Perhaps888/Perhaps888-MOCHAN_Robot/docs/images/camera-placeholder.jpg

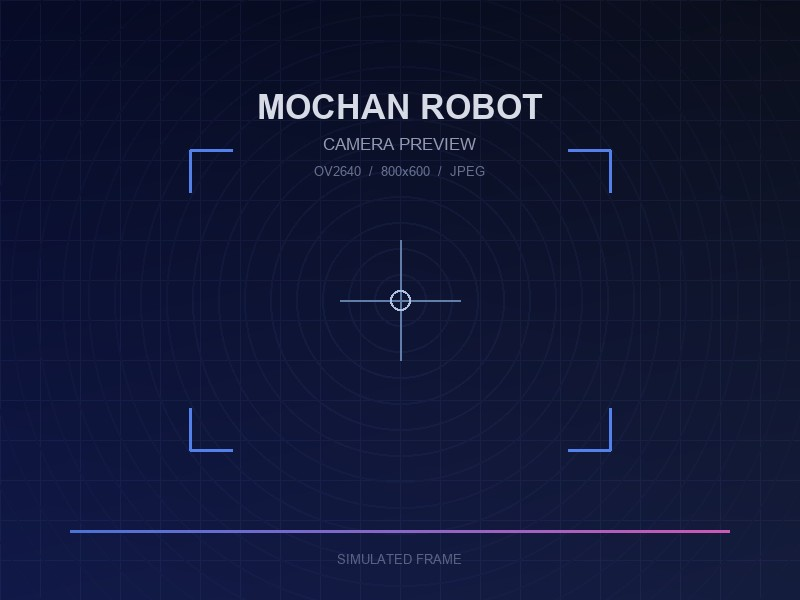
docs/images/camera-placeholder.jpg
