Perhaps888/Perhaps888-MOCHAN_Robot/web_content.h

#pragma once
/* ================================================================
 *  WEB UI 页面内容 (Samsung OneUI 8.5 风格)
 *  ---------------------------------------------------------------
 *  存为 PROGMEM (Flash 只读)，不占用宝贵的 DRAM。
 *  使用普通字符串字面量 + \" 转义，避免 Arduino IDE 的
 *  .ino 预处理器因不理解 R"delim()" 原始字符串语法而
 *  错误配对引号导致 JS function 关键字泄漏到 C++ 作用域。
 * ================================================================ */
#include <Arduino.h>  // PROGMEM 宏定义

/* 页面代码地图:
 *   1. CSS  : 主题变量、卡片、D-Pad、三档转速滑块、响应式布局
 *   2. HTML : 摄像头、方向控制、快捷操作、状态、网络设置
 *   3. JS   : WebSocket 控制、视频流、时钟、状态轮询、三档调速
 *
 * 说明:
 *   整个页面用 C++ 字符串拼接后放进 PROGMEM;
 *   下面新增的 // 注释只给源码阅读, 不会发送给浏览器.
 */
/* ====== 控制台主页面 (~508 行 HTML/CSS/JS) ====== */
const char PAGE_HTML_MAIN[] PROGMEM =
"<!DOCTYPE html>\n"
"<html lang=\"zh-CN\">\n"
"<head>\n"
"<meta charset=\"UTF-8\">\n"
"<meta name=\"viewport\" content=\"width=device-width, initial-scale=1.0, maximum-scale=1.0, user-scalable=no\">\n"
"<meta name=\"apple-mobile-web-app-capable\" content=\"yes\">\n"
"<meta name=\"theme-color\" content=\"#0B1020\">\n"
"<title>MOCHAN Robot · 控制台</title>\n"
"<style>\n"
"*,*::before,*::after{box-sizing:border-box;margin:0;padding:0;-webkit-tap-highlight-color:transparent}\n"
":root{\n"
"  --bg-1:#050816;--bg-2:#0B1030;--bg-3:#101A4A;\n"
"  --glass:rgba(255,255,255,.06);--glass-2:rgba(255,255,255,.10);\n"
"  --border:rgba(255,255,255,.12);\n"
"  --text:#E8ECF5;--text-2:#A8B0C5;--text-3:#76809A;\n"
"  --accent:#5B8CFF;--accent-2:#8A6BFF;--accent-g:linear-gradient(135deg,#5B8CFF,#8A6BFF 60%,#FF6BD6);\n"
"  --danger:#FF4D6A;--success:#3DDC97;--warn:#FFB547;\n"
"  --r-lg:26px;--r-md:18px;--r-sm:12px;--r-xs:10px;\n"
"  --sh-card:0 10px 40px rgba(0,0,0,.45), inset 0 1px 0 rgba(255,255,255,.06);\n"
"  /* ---- 设计 token (统一间距/过渡/焦点,便于桌面/平板差异化微调) ---- */\n"
"  --sp-1:6px;--sp-2:10px;--sp-3:14px;--sp-4:18px;--sp-5:24px;\n"
"  --tr-fast:.15s cubic-bezier(.4,0,.2,1);\n"
"  --tr-base:.25s cubic-bezier(.4,0,.2,1);\n"
"  --tr-slow:.4s cubic-bezier(.22,1,.36,1);\n"
"  --focus:0 0 0 3px rgba(91,140,255,.45);\n"
"}\n"
"html,body{height:100%}\n"
"body{\n"
"  font-family:-apple-system,BlinkMacSystemFont,\"Segoe UI\",\"PingFang SC\",\"Hiragino Sans GB\",\"Microsoft YaHei\",Roboto,sans-serif;\n"
"  color:var(--text);background:#050816;min-height:100vh;\n"
"  background-image:\n"
"    radial-gradient(1200px 600px at 10% -10%,rgba(91,140,255,.35),transparent 60%),\n"
"    radial-gradient(900px 500px at 110% 10%,rgba(138,107,255,.28),transparent 55%),\n"
"    radial-gradient(700px 500px at 50% 120%,rgba(255,107,214,.18),transparent 55%),\n"
"    linear-gradient(180deg,var(--bg-1),var(--bg-2) 50%,var(--bg-3));\n"
"  padding:18px 16px 120px;overflow-x:hidden;\n"
"}\n"
"body::before{content:\"\";position:fixed;inset:0;pointer-events:none;z-index:0;\n"
"  background-image:url(\"data:image/svg+xml;utf8,<svg xmlns='http://www.w3.org/2000/svg' width='120' height='120'><filter id='n'><feTurbulence baseFrequency='.85' numOctaves='2' seed='3'/><feColorMatrix values='0 0 0 0 1 0 0 0 0 1 0 0 0 0 1 0 0 0 .04 0'/></filter><rect width='100%25' height='100%25' filter='url(%23n)'/></svg>\");\n"
"  opacity:.6;mix-blend-mode:overlay;\n"
"}\n"
".container{max-width:760px;margin:0 auto;position:relative;z-index:1}\n"
"\n"
"/* ===== Header ===== */\n"
".header{\n"
"  display:flex;align-items:flex-end;justify-content:space-between;\n"
"  padding:6px 6px 18px;\n"
"}\n"
".h-left .greeting{font-size:13px;color:var(--text-3);letter-spacing:.5px}\n"
".h-left .clock{font-size:34px;font-weight:700;letter-spacing:1px;margin-top:2px;\n"
"  background:var(--accent-g);-webkit-background-clip:text;background-clip:text;color:transparent;\n"
"  text-shadow:0 0 24px rgba(91,140,255,.2);\n"
"}\n"
".h-left .date{font-size:13px;color:var(--text-2);margin-top:2px}\n"
".h-right{text-align:right}\n"
".brand{font-size:14px;font-weight:700;letter-spacing:1.5px;color:var(--text);opacity:.95}\n"
".brand-sub{font-size:11px;color:var(--text-3);margin-top:3px;letter-spacing:1px}\n"
".status-pill{\n"
"  display:inline-flex;align-items:center;gap:6px;margin-top:8px;\n"
"  padding:5px 10px;border-radius:999px;background:var(--glass);\n"
"  border:1px solid var(--border);font-size:11px;color:var(--text-2);backdrop-filter:blur(10px);\n"
"}\n"
".status-dot{width:7px;height:7px;border-radius:50%;background:var(--success);box-shadow:0 0 0 0 rgba(61,220,151,.7);animation:pulse 2s infinite}\n"
"@keyframes pulse{0%{box-shadow:0 0 0 0 rgba(61,220,151,.55)}70%{box-shadow:0 0 0 10px rgba(61,220,151,0)}100%{box-shadow:0 0 0 0 rgba(61,220,151,0)}}\n"
"\n"
"/* ===== Cards ===== */\n"
".card{\n"
"  margin-top:14px;border-radius:var(--r-lg);\n"
"  background:var(--glass);border:1px solid var(--border);\n"
"  backdrop-filter:blur(18px) saturate(140%);-webkit-backdrop-filter:blur(18px) saturate(140%);\n"
"  box-shadow:var(--sh-card);padding:18px 18px 20px;overflow:hidden;position:relative;\n"
"}\n"
".card::before{content:\"\";position:absolute;inset:-1px;border-radius:inherit;\n"
"  background:linear-gradient(135deg,rgba(255,255,255,.18),transparent 40%,transparent 60%,rgba(138,107,255,.18));\n"
"  -webkit-mask:linear-gradient(#000 0 0) content-box,linear-gradient(#000 0 0);\n"
"  -webkit-mask-composite:xor;mask-composite:exclude;padding:1px;pointer-events:none;z-index:0;\n"
"}\n"
".card>*{position:relative;z-index:1}\n"
".card-title{\n"
"  display:flex;align-items:center;gap:8px;font-size:15px;font-weight:700;margin-bottom:14px;\n"
"  letter-spacing:.3px;color:var(--text);\n"
"}\n"
".card-title::before{content:\"\";width:4px;height:16px;border-radius:4px;background:var(--accent-g)}\n"
".card-title .count{margin-left:auto;font-size:11px;color:var(--text-3);font-weight:500}\n"
"\n"
"/* ===== Camera Stream ===== */\n"
".stream-box{\n"
"  position:relative;border-radius:var(--r-md);overflow:hidden;\n"
"  background:#000;border:1px solid var(--border);\n"
"  box-shadow:inset 0 0 0 1px rgba(255,255,255,.04);\n"
"}\n"
".stream-header{\n"
"  position:absolute;top:10px;left:10px;right:10px;display:flex;justify-content:space-between;align-items:center;z-index:2;\n"
"}\n"
".stream-tag{padding:5px 10px;border-radius:999px;font-size:11px;font-weight:600;\n"
"  background:rgba(0,0,0,.5);backdrop-filter:blur(8px);border:1px solid var(--border);color:var(--text)}\n"
".live{padding:5px 10px;border-radius:999px;font-size:11px;font-weight:800;letter-spacing:1px;\n"
"  background:rgba(255,77,106,.18);color:#FF6B84;border:1px solid rgba(255,77,106,.4);\n"
"  display:inline-flex;align-items:center;gap:6px;backdrop-filter:blur(8px);\n"
"}\n"
".live::before{content:\"\";width:7px;height:7px;border-radius:50%;background:#FF4D6A;animation:blink 1.2s infinite}\n"
"@keyframes blink{0%,100%{opacity:1}50%{opacity:.25}}\n"
".stream-box img{width:100%;height:auto;display:block;\n"
"  transform:scale(1.001);transition:transform .4s ease;\n"
"}\n"
"/* AI 检测叠加层: 盖在视频上画框, 不拦截点击 */\n"
"#aiOverlay{position:absolute;left:0;top:0;width:100%;height:100%;pointer-events:none;z-index:3}\n"
".ai-btn{background:linear-gradient(135deg,#1c2b4a,#16213c);border:1px solid var(--border);color:#7fd0ff;\n"
"  border-radius:999px;padding:4px 12px;font-size:12px;cursor:pointer;transition:all .2s}\n"
".ai-btn.on{background:linear-gradient(135deg,#0b5ed7,#0a3d91);color:#fff;border-color:#0d6efd}\n"
".ai-btn:disabled{opacity:.45;cursor:default}\n"
".ai-state{color:var(--text-3);font-size:12px}\n"
"/* AI 模型上传弹窗 */\n"
"#aiModal{position:fixed;inset:0;background:rgba(0,0,0,.65);display:none;place-items:center;z-index:50}\n"
"#aiModal.show{display:grid}\n"
".ai-modal-card{background:#10162b;border:1px solid var(--border);border-radius:16px;padding:22px;width:min(92vw,420px)}\n"
".ai-modal-card h3{margin:0 0 6px;color:#fff;font-size:16px}\n"
".ai-modal-card p{margin:0 0 12px;color:var(--text-3);font-size:12px;line-height:1.7}\n"
".ai-modal-card code{color:#7fd0ff}\n"
"#aiFile{width:100%;color:#ccc;font-size:12px;margin-bottom:10px}\n"
"#aiUpProg{font-size:12px;color:#6f6;white-space:pre-line;min-height:1.2em}\n"
".stream-box:hover img{transform:scale(1.01)}\n"
".stream-foot{\n"
"  margin-top:10px;display:flex;justify-content:space-between;align-items:center;font-size:12px;color:var(--text-3);\n"
"}\n"
".stream-foot .res{padding:3px 8px;border-radius:8px;background:var(--glass);border:1px solid var(--border);color:var(--text-2);font-size:11px}\n"
"\n"
"/* ===== D-Pad ===== */\n"
".dpad{\n"
"  --s:260px;width:100%;max-width:var(--s);aspect-ratio:1;margin:8px auto 4px;\n"
"  display:grid;grid-template-columns:repeat(3,1fr);grid-template-rows:repeat(3,1fr);gap:10px;\n"
"  padding:8px;\n"
"}\n"
".dpad .btn{\n"
"  position:relative;appearance:none;border:none;cursor:pointer;\n"
"  border-radius:22px;background:var(--glass);border:1px solid var(--border);\n"
"  color:var(--text);font-size:22px;font-weight:700;\n"
"  display:flex;align-items:center;justify-content:center;\n"
"  box-shadow:inset 0 1px 0 rgba(255,255,255,.08),0 6px 20px rgba(0,0,0,.3);\n"
"  transition:transform .12s ease,background .2s,box-shadow .2s,color .2s;user-select:none;\n"
"}\n"
".dpad .btn:hover{background:var(--glass-2)}\n"
".dpad .btn:active{transform:scale(.92);box-shadow:inset 0 2px 8px rgba(0,0,0,.45)}\n"
".dpad .up{grid-column:2;grid-row:1}\n"
".dpad .left{grid-column:1;grid-row:2}\n"
".dpad .right{grid-column:3;grid-row:2}\n"
".dpad .down{grid-column:2;grid-row:3}\n"
".dpad .stop{\n"
"  grid-column:2;grid-row:2;border-radius:50%;\n"
"  background:var(--accent-g);color:#fff;font-size:14px;letter-spacing:1px;\n"
"  box-shadow:0 8px 30px rgba(91,140,255,.35),inset 0 1px 0 rgba(255,255,255,.25);\n"
"}\n"
".dpad .stop:active{box-shadow:0 4px 14px rgba(91,140,255,.35)}\n"
".dpad .btn span{opacity:.85}\n"
".hint{text-align:center;font-size:11px;color:var(--text-3);margin-top:4px}\n"
"\n"
"/* ===== 电机转速滑块 (DRV8833 · 3 档) ===== */\n"
".speed-box{margin-top:16px;padding-top:14px;border-top:1px solid rgba(255,255,255,.08)}\n"
".sp-head{display:flex;align-items:center;gap:8px;margin-bottom:6px}\n"
".sp-ico{width:28px;height:28px;flex:0 0 auto;display:grid;place-items:center;border-radius:9px;\n"
"  background:rgba(91,140,255,.14);border:1px solid rgba(91,140,255,.25);font-size:14px}\n"
".sp-title{font-size:12.5px;font-weight:700;color:var(--text-2);letter-spacing:.3px}\n"
".sp-badge{margin-left:auto;display:inline-flex;align-items:baseline;gap:5px;padding:4px 10px;border-radius:999px;\n"
"  background:var(--glass);border:1px solid var(--border);font-size:10.5px;color:var(--text-3);font-variant-numeric:tabular-nums}\n"
".sp-badge b{font-size:12.5px;font-weight:800;color:var(--text);letter-spacing:.5px}\n"
".sp-shell{padding:2px 11px 0}\n"
".sp-range{--fill:100%;-webkit-appearance:none;appearance:none;display:block;width:100%;height:30px;margin:0;\n"
"  background:transparent;outline:none;cursor:pointer;touch-action:pan-y}\n"
".sp-range::-webkit-slider-runnable-track{height:8px;border-radius:999px;border:1px solid var(--border);\n"
"  background-color:rgba(91,140,255,.12);\n"
"  background-image:linear-gradient(90deg,#5B8CFF,#8A6BFF 55%,#FF6BD6);\n"
"  background-size:var(--fill) 100%;background-repeat:no-repeat;\n"
"  box-shadow:inset 0 1px 2px rgba(0,0,0,.35)}\n"
".sp-range::-webkit-slider-thumb{-webkit-appearance:none;appearance:none;width:22px;height:22px;margin-top:-8px;\n"
"  border-radius:50%;border:2px solid rgba(160,190,255,.95);background:linear-gradient(180deg,#fff,#D9E2FF);\n"
"  box-shadow:0 3px 12px rgba(91,140,255,.55),0 0 0 4px rgba(91,140,255,.10);\n"
"  transition:transform var(--tr-fast),box-shadow var(--tr-fast)}\n"
".sp-range:active::-webkit-slider-thumb{transform:scale(1.08);\n"
"  box-shadow:0 4px 18px rgba(91,140,255,.7),0 0 0 6px rgba(91,140,255,.14)}\n"
".sp-range:focus-visible{outline:none}\n"
".sp-range::-moz-range-track{height:8px;border-radius:999px;border:1px solid var(--border);background:rgba(91,140,255,.12)}\n"
".sp-range::-moz-range-progress{height:8px;border-radius:999px;background:linear-gradient(90deg,#5B8CFF,#8A6BFF 55%,#FF6BD6)}\n"
".sp-range::-moz-range-thumb{width:20px;height:20px;border-radius:50%;border:2px solid rgba(160,190,255,.95);\n"
"  background:linear-gradient(180deg,#fff,#D9E2FF);box-shadow:0 3px 12px rgba(91,140,255,.55)}\n"
".sp-scale{display:flex;justify-content:space-between;margin-top:2px}\n"
".sp-step{appearance:none;border:none;background:transparent;color:var(--text-3);cursor:pointer;\n"
"  display:flex;flex-direction:column;align-items:center;gap:4px;padding:2px 0 1px;min-width:30px;\n"
"  font-family:inherit;font-size:11px;font-weight:600;letter-spacing:.5px;transition:color var(--tr-fast)}\n"
".sp-step i{display:block;width:5px;height:5px;border-radius:50%;background:rgba(255,255,255,.18);transition:all var(--tr-fast)}\n"
".sp-step:hover{color:var(--text-2)}\n"
".sp-step.active{color:var(--text)}\n"
".sp-step.active i{background:var(--accent);box-shadow:0 0 8px rgba(91,140,255,.95);transform:scale(1.15)}\n"
".sp-sub{display:flex;justify-content:space-between;gap:10px;margin-top:6px;font-size:10.5px;color:var(--text-3);letter-spacing:.2px}\n"
".sp-sub b{color:var(--text-2);font-weight:600}\n"
"\n"
"/* ===== Segmented (运行模式) ===== */\n"
".seg{\n"
"  display:grid;grid-template-columns:repeat(3,1fr);gap:8px;padding:6px;\n"
"  border-radius:999px;background:var(--glass);border:1px solid var(--border);\n"
"}\n"
".seg button{\n"
"  appearance:none;border:none;cursor:pointer;padding:10px 8px;border-radius:999px;\n"
"  background:transparent;color:var(--text-2);font-size:13px;font-weight:600;letter-spacing:.3px;\n"
"  transition:all .25s ease;\n"
"}\n"
".seg button.active,.seg button.on{\n"
"  background:var(--accent-g);color:#fff;box-shadow:0 6px 20px rgba(91,140,255,.3);\n"
"}\n"
".seg button:not(.active):not(.on):hover{background:rgba(255,255,255,.05);color:var(--text)}\n"
"\n"
"/* ===== Buttons ===== */\n"
".btn-primary,.btn-ghost{\n"
"  appearance:none;border:none;cursor:pointer;width:100%;padding:12px 14px;\n"
"  border-radius:var(--r-sm);font-size:13.5px;font-weight:700;letter-spacing:.3px;\n"
"  display:inline-flex;align-items:center;justify-content:center;gap:8px;transition:all .2s ease;\n"
"}\n"
".btn-primary{\n"
"  background:var(--accent-g);color:#fff;\n"
"  box-shadow:0 10px 26px rgba(91,140,255,.3),inset 0 1px 0 rgba(255,255,255,.2);\n"
"}\n"
".btn-primary:hover{transform:translateY(-1px);box-shadow:0 14px 34px rgba(91,140,255,.4),inset 0 1px 0 rgba(255,255,255,.25)}\n"
".btn-primary:active{transform:translateY(0);box-shadow:0 6px 16px rgba(91,140,255,.35)}\n"
".btn-ghost{background:var(--glass);color:var(--text);border:1px solid var(--border)}\n"
".btn-ghost:hover{background:var(--glass-2)}\n"
".btn-primary.loading{pointer-events:none;opacity:.8}\n"
".btn-primary .spin{width:14px;height:14px;border:2px solid rgba(255,255,255,.3);border-top-color:#fff;border-radius:50%;animation:spin .8s linear infinite}\n"
"@keyframes spin{to{transform:rotate(360deg)}}\n"
"\n"
"/* ===== 屏幕文字发送条 ===== */\n"
".chatbar{\n"
"  margin-top:18px;padding:7px 7px 7px 16px;border-radius:999px;\n"
"  display:flex;align-items:center;gap:10px;\n"
"  background:rgba(8,12,30,.55);border:1px solid var(--border);\n"
"  backdrop-filter:blur(10px);\n"
"  box-shadow:inset 0 1px 0 rgba(255,255,255,.05),0 8px 22px rgba(0,0,0,.28);\n"
"  transition:border-color .25s,box-shadow .25s,background .25s;\n"
"}\n"
".chatbar:focus-within{\n"
"  border-color:transparent;background:rgba(10,15,38,.82);\n"
"  box-shadow:0 0 0 2px rgba(91,140,255,.5),0 10px 28px rgba(91,140,255,.22),inset 0 1px 0 rgba(255,255,255,.06);\n"
"}\n"
".chatbar .cb-ico{font-size:15px;line-height:1;opacity:.75;flex:0 0 auto;filter:saturate(1.1)}\n"
".chatbar input{\n"
"  flex:1;min-width:0;appearance:none;border:none;background:transparent;outline:none;\n"
"  color:var(--text);font-size:13.5px;font-weight:500;letter-spacing:.2px;padding:9px 2px;\n"
"}\n"
".chatbar input::placeholder{color:var(--text-3);font-weight:400}\n"
".chatbar .cb-count{font-size:10px;color:var(--text-3);font-variant-numeric:tabular-nums;flex:0 0 auto;padding-right:2px}\n"
".chatbar .cb-send{\n"
"  appearance:none;border:none;cursor:pointer;flex:0 0 auto;\n"
"  height:38px;padding:0 18px;border-radius:999px;\n"
"  background:var(--accent-g);color:#fff;font-size:13px;font-weight:700;letter-spacing:.5px;\n"
"  display:inline-flex;align-items:center;gap:6px;\n"
"  box-shadow:0 8px 20px rgba(91,140,255,.34),inset 0 1px 0 rgba(255,255,255,.22);\n"
"  transition:transform .18s,box-shadow .18s,filter .18s;\n"
"}\n"
".chatbar .cb-send:hover{transform:translateY(-1px);box-shadow:0 12px 26px rgba(91,140,255,.44),inset 0 1px 0 rgba(255,255,255,.25)}\n"
".chatbar .cb-send:active{transform:translateY(0) scale(.97);box-shadow:0 5px 14px rgba(91,140,255,.32)}\n"
"@media(max-width:600px){\n"
"  .chatbar{padding:6px 6px 6px 14px}\n"
"  .chatbar .cb-send{height:36px;padding:0 15px}\n"
"}\n"
"\n"
"/* ===== 设备状态仪表盘 ===== */\n"
".tele-grid{display:grid;grid-template-columns:1fr 1fr;gap:10px}\n"
".tele{display:flex;align-items:center;gap:11px;padding:12px 14px;border-radius:16px;background:var(--glass);border:1px solid var(--border)}\n"
".t-ico{font-size:17px;flex:0 0 auto;width:34px;height:34px;display:grid;place-items:center;border-radius:11px;background:rgba(91,140,255,.14);border:1px solid rgba(91,140,255,.25)}\n"
".t-body{min-width:0}\n"
".t-val{font-size:13.5px;font-weight:700;color:var(--text);font-variant-numeric:tabular-nums;line-height:1.25;white-space:nowrap}\n"
".t-k{font-size:10.5px;color:var(--text-3);margin-top:2px;white-space:nowrap;overflow:hidden;text-overflow:ellipsis}\n"
"\n"
"/* ===== 小车状态 + 表情 ===== */\n"
".car-dir{display:flex;align-items:center;gap:13px;padding:13px 15px;border-radius:16px;background:var(--glass);border:1px solid var(--border)}\n"
".cd-ico{font-size:20px;width:46px;height:46px;flex:0 0 auto;display:grid;place-items:center;border-radius:14px;background:linear-gradient(135deg,rgba(91,140,255,.22),rgba(138,107,255,.22));border:1px solid var(--border)}\n"
".cd-meta{flex:1;min-width:0}\n"
".cd-txt{font-size:14.5px;font-weight:700;line-height:1.2}\n"
".cd-sub{font-size:11px;color:var(--text-3);margin-top:3px;white-space:nowrap;overflow:hidden;text-overflow:ellipsis}\n"
".cd-dot{width:9px;height:9px;border-radius:50%;background:var(--text-3);flex:0 0 auto;transition:background .3s}\n"
".cd-dot.run{background:#3DDC97;box-shadow:0 0 10px rgba(61,220,151,.9);animation:pulseDot 1.2s ease-in-out infinite}\n"
"@keyframes pulseDot{0%,100%{opacity:1}50%{opacity:.35}}\n"
".mood-label{font-size:11px;color:var(--text-3);margin:14px 2px 8px;letter-spacing:.5px}\n"
".moods{display:grid;grid-template-columns:repeat(4,1fr);gap:8px}\n"
".mood{appearance:none;border:1px solid var(--border);background:var(--glass);color:var(--text-2);border-radius:14px;padding:10px 4px 8px;cursor:pointer;font-size:18px;line-height:1;display:flex;flex-direction:column;align-items:center;gap:5px;transition:all .2s}\n"
".mood span{font-size:11px;font-weight:600}\n"
".mood:hover{background:var(--glass-2);transform:translateY(-1px)}\n"
".mood.active{border-color:transparent;background:rgba(91,140,255,.16);color:var(--text);box-shadow:0 0 0 1.5px rgba(91,140,255,.55),0 10px 24px rgba(91,140,255,.25)}\n"
"\n"
"/* ===== Quick Actions ===== */\n"
".quick{display:grid;grid-template-columns:repeat(3,1fr);gap:10px}\n"
"\n"
"/* ===== WiFi 设置 ===== */\n"
".wifi-card .wifi-status{display:flex;align-items:center;gap:11px;padding:13px 15px;border-radius:16px;background:var(--glass);border:1px solid var(--border);margin-bottom:12px}\n"
".wifi-card .ws-ico{font-size:20px;width:42px;height:42px;flex:0 0 auto;display:grid;place-items:center;border-radius:13px;background:linear-gradient(135deg,rgba(91,140,255,.22),rgba(138,107,255,.22));border:1px solid var(--border)}\n"
".wifi-card .ws-info{flex:1;min-width:0}\n"
".wifi-card .ws-ssid{font-size:14px;font-weight:700;line-height:1.2;white-space:nowrap;overflow:hidden;text-overflow:ellipsis}\n"
".wifi-card .ws-ip{font-size:11px;color:var(--text-3);margin-top:2px;font-variant-numeric:tabular-nums}\n"
".wifi-card .ws-badge{font-size:10px;font-weight:700;padding:3px 9px;border-radius:999px;flex:0 0 auto;letter-spacing:.5px}\n"
".wifi-card .ws-badge.sta{background:rgba(61,220,151,.16);color:#3DDC97;border:1px solid rgba(61,220,151,.3)}\n"
".wifi-card .ws-badge.ap{background:rgba(255,170,46,.14);color:#FFAA2E;border:1px solid rgba(255,170,46,.28)}\n"
".wifi-card .wifi-input{appearance:none;width:100%;border:1px solid var(--border);background:var(--glass);color:var(--text);font-size:13.5px;font-weight:500;padding:11px 14px;border-radius:14px;outline:none;transition:border-color .2s,box-shadow .2s;box-sizing:border-box}\n"
".wifi-card .wifi-input:focus{border-color:rgba(91,140,255,.5);box-shadow:0 0 0 3px rgba(91,140,255,.15)}\n"
".wifi-card .wifi-input::placeholder{color:var(--text-3);font-weight:400}\n"
".wifi-scan-wrap{display:flex;gap:8px;align-items:center;margin-bottom:10px}\n"
".wifi-scan-wrap .wifi-input{flex:1}\n"
".wifi-scan-btn{appearance:none;border:1px solid var(--border);background:var(--glass);color:var(--text);font-size:13px;font-weight:600;padding:11px 16px;border-radius:14px;cursor:pointer;flex:0 0 auto;transition:all .2s;display:flex;align-items:center;gap:5px}\n"
".wifi-scan-btn:hover{background:var(--glass-2);transform:translateY(-1px)}\n"
".wifi-scan-btn:active{transform:translateY(0)}\n"
".wifi-scan-btn:disabled{opacity:.5;cursor:default}\n"
".wifi-list{width:100%;border:1px solid var(--border);background:var(--glass);color:var(--text);border-radius:14px;padding:6px;margin-bottom:10px;outline:none;font-size:13px;max-height:140px}\n"
".wifi-list option{padding:8px 10px;border-radius:8px}\n"
".wifi-list option:checked{background:rgba(91,140,255,.2)}\n"
".wifi-actions{display:grid;grid-template-columns:1fr 1fr;gap:10px}\n"
".wifi-btn{appearance:none;border:none;cursor:pointer;padding:12px;border-radius:14px;font-size:13px;font-weight:700;letter-spacing:.3px;transition:all .2s;display:flex;align-items:center;justify-content:center;gap:6px}\n"
".wifi-btn:active{transform:scale(.97)}\n"
".wifi-btn.connect{background:linear-gradient(135deg,#5B8CFF,#6B5BFF);color:#fff;box-shadow:0 8px 20px rgba(91,140,255,.34)}\n"
".wifi-btn.connect:hover{box-shadow:0 12px 28px rgba(91,140,255,.44);transform:translateY(-1px)}\n"
".wifi-btn.apmode{background:var(--glass);border:1px solid var(--border);color:var(--text-2)}\n"
".wifi-btn.apmode:hover{background:var(--glass-2);transform:translateY(-1px)}\n"
".wifi-hint{font-size:11px;color:var(--text-3);line-height:1.55;margin-top:10px;display:flex;gap:6px;align-items:flex-start}\n"
".wifi-hint::before{content:\"ⓘ\";flex:0 0 auto;font-size:13px;opacity:.7}\n"
".qa{\n"
"  appearance:none;border:none;cursor:pointer;padding:16px 6px 14px;border-radius:20px;\n"
"  background:var(--glass);border:1px solid var(--border);color:var(--text);text-align:center;\n"
"  transition:all .25s ease;display:flex;flex-direction:column;align-items:center;gap:4px;position:relative;overflow:hidden;\n"
"}\n"
".qa::after{content:\"\";position:absolute;inset:0;background:var(--accent-g);opacity:0;transition:opacity .3s;mix-blend-mode:overlay;pointer-events:none}\n"
".qa:hover{transform:translateY(-2px);background:var(--glass-2);box-shadow:0 14px 30px rgba(0,0,0,.4)}\n"
".qa:hover::after{opacity:.4}\n"
".qa:active{transform:translateY(0)}\n"
"/* 运行模式激活态:蓝色描边+柔光投影+渐变叠加混色层更明显 */\n"
".qa.active{\n"
"  border-color:transparent;\n"
"  background:rgba(91,140,255,.16);\n"
"  box-shadow:0 0 0 1.5px rgba(91,140,255,.55),0 14px 34px rgba(91,140,255,.28)\n"
"}\n"
".qa.active::after{opacity:.55}\n"
".qa .ico{font-size:26px;line-height:1}\n"
".qa .lbl{font-size:13px;font-weight:700}\n"
".qa .dsc{font-size:10.5px;color:var(--text-3)}\n"
"\n"
"/* ===== Footer ===== */\n"
".footer{\n"
"  margin-top:24px;text-align:center;font-size:11px;color:var(--text-3);letter-spacing:1.2px;\n"
"  opacity:.8;\n"
"}\n"
".footer .bar{margin:0 auto 8px;width:38px;height:4px;border-radius:999px;\n"
"  background:linear-gradient(90deg,var(--accent),var(--accent-2));opacity:.7}\n"
"\n"
"/* ===== Toast ===== */\n"
".toast{\n"
"  position:fixed;left:50%;top:20px;transform:translate(-50%,-20px);z-index:999;\n"
"  padding:10px 16px;border-radius:999px;font-size:12.5px;font-weight:600;\n"
"  background:rgba(15,20,48,.9);color:#fff;border:1px solid var(--border);\n"
"  backdrop-filter:blur(14px);box-shadow:0 10px 40px rgba(0,0,0,.5);\n"
"  opacity:0;pointer-events:none;transition:opacity .25s,transform .25s;\n"
"}\n"
".toast.show{opacity:1;transform:translate(-50%,0)}\n"
".toast.ok{border-color:rgba(61,220,151,.35)}\n"
".toast.err{border-color:rgba(255,77,106,.45)}\n"
"\n"
"/* ===== 全局桌面体验增强 ===== */\n"
"@media (hover:hover) and (pointer:fine){\n"
"  html{scroll-behavior:smooth}\n"
"  button:focus-visible,a:focus-visible,input:focus-visible,select:focus-visible{\n"
"    outline:none;box-shadow:var(--focus),0 6px 24px rgba(91,140,255,.18);border-radius:inherit\n"
"  }\n"
"  ::selection{background:rgba(91,140,255,.35);color:#fff}\n"
"}\n"
"\n"
"/* ===== 平板 (768-1023px): 轻微放宽, 保持单栏 ===== */\n"
"@media (min-width:768px) and (max-width:1023px){\n"
"  .container{max-width:740px}\n"
"  body{padding:26px 20px 120px}\n"
"  .h-left .clock{font-size:40px;letter-spacing:1.5px}\n"
"  .dpad{--s:290px;gap:12px}\n"
"  .card{padding:20px 20px 22px}\n"
"  .card-title{margin-bottom:16px}\n"
"  .quick .qa{padding:18px 10px 16px}\n"
"  .quick .qa .ico{font-size:28px}\n"
"  .seg button{padding:11px 10px;font-size:13.5px}\n"
"}\n"
"\n"
"/* ===== 桌面端 (>=1024px): 双栏网格, 左(画面/状态)右(控制/快捷) ===== */\n"
"@media (min-width:1024px){\n"
"  body{padding:32px 28px 140px}\n"
"  .container{\n"
"    max-width:1180px;\n"
"    display:grid;\n"
"    grid-template-columns:1.25fr 1fr;\n"
"    grid-template-rows:auto auto auto auto auto;\n"
"    grid-template-areas:\n"
"      \"header header\"\n"
"      \"cam    dpad\"\n"
"      \"stats  quick\"\n"
"      \"car    quick\"\n"
"      \"footer footer\";\n"
"    column-gap:24px;row-gap:18px;align-items:stretch\n"
"  }\n"
"  /* 顶部区域全宽 */\n"
"  .container>.header{grid-area:header;padding:8px 8px 10px;align-items:center}\n"
"  .header .h-left .greeting{font-size:13px}\n"
"  .header .h-left .clock{font-size:48px;letter-spacing:2px}\n"
"  .header .h-left .date{font-size:13.5px;margin-top:4px}\n"
"  .header .h-right .brand{font-size:15px;letter-spacing:2px}\n"
"  .header .h-right .brand-sub{font-size:12px}\n"
"  .header .status-pill{padding:7px 14px;font-size:12px;gap:8px}\n"
"  /* 卡片在 grid 中取消外边距,统一由 row-gap 控制,内 padding 加大更宽松 */\n"
".container>.card{margin-top:0;padding:22px 24px 24px;border-radius:28px}\n"
".container>.card .card-title{font-size:16px;margin-bottom:16px;letter-spacing:.4px}\n"
"  /* 左栏:摄像头(跨2行,对齐右栏 D-Pad+快捷操作 的总高度) */\n"
".container>.card-cam{grid-area:cam}\n"
".stream-box{border-radius:22px}\n"
".stream-foot{margin-top:14px;font-size:13px}\n"
"  /* 右栏顶部:方向控制 */\n"
".container>.card-dpad{grid-area:dpad}\n"
".dpad{--s:320px;gap:14px;padding:10px}\n"
".dpad .btn{font-size:24px;border-radius:24px}\n"
".dpad .stop{font-size:15px}\n"
".container>.card-stats{grid-area:stats}\n"
".container>.card-car{grid-area:car}\n"
"  /* 右栏底部:快捷操作(含运行模式 3列×2行; 跨2行与状态两卡对齐) */\n"
".container>.card-quick{grid-area:quick}\n"
".quick{gap:12px}\n"
".quick .qa{padding:18px 8px 16px;border-radius:22px}\n"
".quick .qa .ico{font-size:28px}\n"
".quick .qa .lbl{font-size:13px}\n"
".quick .qa .dsc{font-size:10.5px}\n"
"  /* 底部全宽 */\n"
"  .container>.footer{grid-area:footer;margin-top:14px;font-size:12px}\n"
"}\n"
"\n"
"/* ===== 大桌面 (>=1440px): 进一步加宽与留白 ===== */\n"
"@media (min-width:1440px){\n"
"  .container{max-width:1320px;column-gap:28px;row-gap:20px}\n"
"  body{padding:38px 40px 160px}\n"
"  .container>.card{padding:26px 28px 28px;border-radius:30px}\n"
"  .header .h-left .clock{font-size:52px}\n"
"  .dpad{--s:340px}\n"
"}\n"
"</style>\n"
"</head>\n"
"<body>\n"
"<div class=\"container\">\n"
"\n"
"  <div class=\"header\">\n"
"    <div class=\"h-left\">\n"
"      <div class=\"greeting\">HELLO, 欢迎回来</div>\n"
"      <div class=\"clock\" id=\"clock\">--:--</div>\n"
"      <div class=\"date\" id=\"date\">--月--日 周-</div>\n"
"    </div>\n"
"    <div class=\"h-right\">\n"
"      <div class=\"brand\">MOCHAN</div>\n"
"      <div class=\"brand-sub\">OneUI 8.5 · Console</div>\n"
"      <div class=\"status-pill\"><span class=\"status-dot\"></span><span id=\"netState\">联机</span></div>\n"
"    </div>\n"
"  </div>\n"
"\n"
"  <!-- 摄像头 -->\n"
"  <div class=\"card card-cam\">\n"
"    <div class=\"card-title\">摄像头预览<span class=\"count\">WS · 实时</span></div>\n"
"    <div class=\"stream-box\">\n"
"      <div class=\"stream-header\">\n"
"        <span class=\"stream-tag\">CAM · 主视角</span>\n"
"        <span class=\"live\">LIVE</span>\n"
"      </div>\n"
"      <img id=\"camStream\" alt=\"Camera Stream\">\n"
"      <canvas id=\"aiOverlay\"></canvas>\n"
"    </div>\n"
"    <div class=\"stream-foot\">\n"
"      <span>分辨率：<span class=\"res\" id=\"resTag\">--</span></span>\n"
"      <span id=\"fpsTag\">FPS · 自适应</span>\n"
"      <span class=\"ai-state\" id=\"aiState\"></span>\n"
"      <button class=\"ai-btn\" id=\"aiBtn\" type=\"button\">🧠 AI 检测</button>\n"
"      <button class=\"ai-btn\" id=\"followBtn\" type=\"button\">🚶 跟随</button>\n"
"    </div>\n"
"  </div>\n"
"\n"
"  <!-- AI 模型上传弹窗 (仅在模型未上传时出现) -->\n"
"  <div id=\"aiModal\">\n"
"    <div class=\"ai-modal-card\">\n"
"      <h3>🧠 上传 AI 模型文件</h3>\n"
"      <p>首次使用需上传 3 个文件（在固件源码目录的 <code>ai_assets</code> 文件夹里），\n"
"      存进机器人 Flash，之后永久离线可用：<br>\n"
"      <code>ort.wasm.min.js.gz</code><br>\n"
"      <code>ort-wasm-simd.wasm.gz</code><br>\n"
"      <code>yolov8n.onnx.gz</code></p>\n"
"      <input type=\"file\" id=\"aiFile\" accept=\".gz\" multiple>\n"
"      <div id=\"aiUpProg\"></div>\n"
"    </div>\n"
"  </div>\n"
"\n"
"  <!-- 方向控制 -->\n"
"  <div class=\"card card-dpad\">\n"
"    <div class=\"card-title\">方向控制<span class=\"count\">按下即发送</span></div>\n"
"    <div class=\"dpad\" id=\"dpad\">\n"
"      <button class=\"btn up\" data-cmd=\"f\" aria-label=\"前进\"><span>▲</span></button>\n"
"      <button class=\"btn left\" data-cmd=\"l\" aria-label=\"左转\"><span>◀</span></button>\n"
"      <button class=\"btn stop\" data-cmd=\"s\" aria-label=\"停止\">STOP</button>\n"
"      <button class=\"btn right\" data-cmd=\"r\" aria-label=\"右转\"><span>▶</span></button>\n"
"      <button class=\"btn down\" data-cmd=\"b\" aria-label=\"后退\"><span>▼</span></button>\n"
"    </div>\n"
"    <div class=\"hint\">Tip · 支持长按连续触发；按 STOP 立即制动。</div>\n"
"\n"
"    <!-- 电机转速 3 档: 慢 / 中 / 快 -->\n"
"    <div class=\"speed-box\">\n"
"      <div class=\"sp-head\">\n"
"        <span class=\"sp-ico\">⚡</span>\n"
"        <span class=\"sp-title\">电机转速</span>\n"
"        <span class=\"sp-badge\"><b id=\"spName\">快</b><span id=\"spPct\">100%</span></span>\n"
"      </div>\n"
"      <div class=\"sp-shell\">\n"
"        <input type=\"range\" id=\"speedRange\" class=\"sp-range\" min=\"0\" max=\"2\" step=\"1\" value=\"2\"\n"
"               aria-label=\"电机转速，三档可调\" aria-valuetext=\"快 100%\">\n"
"        <div class=\"sp-scale\" id=\"spScale\">\n"
"          <button type=\"button\" class=\"sp-step\" data-sp=\"0\"><i></i>慢</button>\n"
"          <button type=\"button\" class=\"sp-step\" data-sp=\"1\"><i></i>中</button>\n"
"          <button type=\"button\" class=\"sp-step active\" data-sp=\"2\"><i></i>快</button>\n"
"        </div>\n"
"      </div>\n"
"      <div class=\"sp-sub\"><span id=\"spDesc\">全力输出</span><span><b>DRV8833</b> · PWM 20kHz</span></div>\n"
"    </div>\n"
"  </div>\n"
"\n"
"  <!-- 快捷操作(含运行模式) · 3列×2行 共6个卡片按钮 -->\n"
"  <div class=\"card card-quick\">\n"
"    <div class=\"card-title\">快捷操作<span class=\"count\">当前模式：<span id=\"modeTxt\">巡航</span></span></div>\n"
"    <div class=\"quick\" id=\"quickGrid\">\n"
"      <button class=\"qa\" onclick=\"sendCmd('dance')\">\n"
"        <span class=\"ico\">💃</span><span class=\"lbl\">跳舞</span><span class=\"dsc\">预设动作</span>\n"
"      </button>\n"
"      <button class=\"qa\" onclick=\"capture()\">\n"
"        <span class=\"ico\">📷</span><span class=\"lbl\">拍照</span><span class=\"dsc\">保存画面</span>\n"
"      </button>\n"
"      <button class=\"qa\" onclick=\"location.href='/ota'\">\n"
"        <span class=\"ico\">🔄</span><span class=\"lbl\">升级</span><span class=\"dsc\">OTA 固件</span>\n"
"      </button>\n"
"      <button class=\"qa\" onclick=\"confirmRestart()\">\n"
"        <span class=\"ico\">🔁</span><span class=\"lbl\">重启</span><span class=\"dsc\">重启设备</span>\n"
"      </button>\n"
"      <button class=\"qa mode-btn\" data-mode=\"off\" onclick=\"setMode('off')\">\n"
"        <span class=\"ico\">😴</span><span class=\"lbl\">休眠</span><span class=\"dsc\">待机省电</span>\n"
"      </button>\n"
"      <button class=\"qa mode-btn\" data-mode=\"soft\" onclick=\"setMode('soft')\">\n"
"        <span class=\"ico\">🧸</span><span class=\"lbl\">柔和</span><span class=\"dsc\">低速安静</span>\n"
"      </button>\n"
"      <button class=\"qa mode-btn active\" data-mode=\"normal\" onclick=\"setMode('normal')\">\n"
"        <span class=\"ico\">🏎️</span><span class=\"lbl\">巡航</span><span class=\"dsc\">全速行驶</span>\n"
"      </button>\n"
"    </div>\n"
"\n"
"    <!-- 屏幕文字发送区 -->\n"
"    <div class=\"chatbar\">\n"
"      <span class=\"cb-ico\">✏️</span>\n"
"      <input type=\"text\" id=\"textInput\" placeholder=\"输入文字，发送到屏幕…\" maxlength=\"40\" autocomplete=\"off\"\n"
"             oninput=\"document.getElementById('cbCount').textContent=this.value.length+'/40'\"\n"
"             onkeydown=\"if(event.key==='Enter')sendText()\">\n"
"      <span class=\"cb-count\" id=\"cbCount\">0/40</span>\n"
"      <button class=\"cb-send\" onclick=\"sendText()\">发送</button>\n"
"    </div>\n"
"  </div>\n"
"\n"
"  <!-- 设备状态仪表盘 -->\n"
"  <div class=\"card card-stats\">\n"
"    <div class=\"card-title\">设备状态<span class=\"count\" id=\"stIp\">--</span></div>\n"
"    <div class=\"tele-grid\">\n"
"      <div class=\"tele\"><span class=\"t-ico\">📶</span><div class=\"t-body\"><div class=\"t-val\" id=\"stRssi\">--</div><div class=\"t-k\" id=\"stSsid\">WiFi</div></div></div>\n"
"      <div class=\"tele\"><span class=\"t-ico\">⏱️</span><div class=\"t-body\"><div class=\"t-val\" id=\"stUptime\">--</div><div class=\"t-k\">运行时长</div></div></div>\n"
"      <div class=\"tele\"><span class=\"t-ico\">🧠</span><div class=\"t-body\"><div class=\"t-val\" id=\"stHeap\">--</div><div class=\"t-k\" id=\"stHeapK\">空闲内存</div></div></div>\n"
"      <div class=\"tele\"><span class=\"t-ico\">🌡️</span><div class=\"t-body\"><div class=\"t-val\" id=\"stTemp\">--</div><div class=\"t-k\">芯片温度</div></div></div>\n"
"      <div class=\"tele\"><span class=\"t-ico\">🔄</span><div class=\"t-body\"><div class=\"t-val\" id=\"stRst\">--</div><div class=\"t-k\">最近重启</div></div></div>\n"
"      <div class=\"tele\"><span class=\"t-ico\">👥</span><div class=\"t-body\"><div class=\"t-val\" id=\"stOnline\">--</div><div class=\"t-k\" id=\"stOnlineK\">在线客户端</div></div></div>\n"
"    </div>\n"
"  </div>\n"
"\n"
"  <!-- 小车运行状态 + 表情 -->\n"
"  <div class=\"card card-car\">\n"
"    <div class=\"card-title\">小车状态<span class=\"count\" id=\"carModeBadge\">巡航</span></div>\n"
"    <div class=\"car-dir\" id=\"carDirBox\">\n"
"      <span class=\"cd-ico\" id=\"carIco\">⏹</span>\n"
"      <div class=\"cd-meta\"><div class=\"cd-txt\" id=\"carDir\">待机中</div><div class=\"cd-sub\" id=\"carSub\">电机待命</div></div>\n"
"      <span class=\"cd-dot\" id=\"carDot\"></span>\n"
"    </div>\n"
"    <div class=\"mood-label\">OLED 表情</div>\n"
"    <div class=\"moods\" id=\"moodBar\">\n"
"      <button class=\"mood active\" data-m=\"0\">😐<span>默认</span></button>\n"
"      <button class=\"mood\" data-m=\"1\">😴<span>疲惫</span></button>\n"
"      <button class=\"mood\" data-m=\"2\">😠<span>生气</span></button>\n"
"      <button class=\"mood\" data-m=\"3\">😊<span>开心</span></button>\n"
"    </div>\n"
"  </div>\n"
"\n"
"  <!-- 网络设置 -->\n"
"  <div class=\"card wifi-card\">\n"
"    <div class=\"card-title\">网络设置</div>\n"
"    <div class=\"wifi-status\">\n"
"      <div class=\"ws-ico\" id=\"wifiStatusIcon\">📶</div>\n"
"      <div class=\"ws-info\">\n"
"        <div class=\"ws-ssid\" id=\"wifiStatusSsid\">MOCHAN 热点</div>\n"
"        <div class=\"ws-ip\" id=\"wifiStatusIp\">192.168.4.1</div>\n"
"      </div>\n"
"      <div class=\"ws-badge ap\" id=\"wifiModeBadge\">AP</div>\n"
"    </div>\n"
"    <div class=\"wifi-scan-wrap\">\n"
"      <input type=\"text\" class=\"wifi-input\" id=\"wifiSsid\" placeholder=\"WiFi 名称\" autocomplete=\"off\">\n"
"      <button class=\"wifi-scan-btn\" onclick=\"scanWifi()\">🔍扫描</button>\n"
"    </div>\n"
"    <select id=\"wifiList\" class=\"wifi-list\" style=\"display:none\" onchange=\"$('#wifiSsid').value=this.value\" size=\"4\"></select>\n"
"    <input type=\"password\" class=\"wifi-input\" id=\"wifiPwd\" placeholder=\"WiFi 密码\" autocomplete=\"off\" style=\"margin-bottom:10px\">\n"
"    <div class=\"wifi-actions\">\n"
"      <button class=\"wifi-btn connect\" onclick=\"connectWifi()\">📶 连接 WiFi</button>\n"
"      <button class=\"wifi-btn apmode\" onclick=\"switchToAP()\">📡 切回热点</button>\n"
"    </div>\n"
"    <div class=\"wifi-hint\">切换到 STA 模式后设备将重启并连接家庭 WiFi，连接成功后请通过 OLED 上的新 IP 访问。断连超 60 秒会自动回退热点模式。</div>\n"
"  </div>\n"
"\n"
"  <div class=\"footer\"><div class=\"bar\"></div>MOCHAN · OneUI 8.5 · Crafted with ❤</div>\n"
"</div>\n"
"\n"
"<div id=\"toast\" class=\"toast\"></div>\n"
"\n"
"<script>\n"
"/* ===== 基础工具 ===== */\n"
"const $=s=>document.querySelector(s);\n"
"const $$=s=>document.querySelectorAll(s);\n"
"function toast(msg,type){\n"
"  const t=$('#toast');t.textContent=msg;t.className='toast show '+(type||'');\n"
"  clearTimeout(t._tm);t._tm=setTimeout(()=>t.className='toast',2200);\n"
"}\n"
"function run(path,btn){\n"
"  fetch('/'+path).then(r=>{if(r.ok)toast('已发送 '+path,'ok');else toast('发送失败','err');})\n"
"    .catch(()=>toast('网络错误','err'));\n"
"}\n"
"\n"
"/* ===== WebSocket 控制通道 (低延迟, 与 ws_cam 视频通道分离) ===== */\n"
"var wsCtrl=null,wsSeq=1;\n"
"function connectWsCtrl(){\n"
"  var proto=location.protocol==='https:'?'wss:':'ws:';\n"
"  wsCtrl=new WebSocket(proto+'//'+location.host+'/ws_ctrl');\n"
"  wsCtrl.onopen=function(){};\n"
"  wsCtrl.onclose=function(){wsCtrl=null;setTimeout(connectWsCtrl,1000);};\n"
"  wsCtrl.onerror=function(){wsCtrl.close();};\n"
"}\n"
"connectWsCtrl();\n"
"/* 统一命令发送: WS 优先 (零握手延迟), HTTP 兜底 */\n"
"function sendCmd(cmd){\n"
"  if(wsCtrl&&wsCtrl.readyState===1){wsCtrl.send(cmd+','+(wsSeq++));}\n"
"  else{fetch('/'+cmd+'?seq='+(wsSeq++)).catch(()=>{});}\n"
"}\n"
"\n"
"/* ===== 视频流: /ws_cam 二进制帧 + 逐帧 ACK 背压, 断线自动降级 MJPEG /stream ===== */\n"
"/* 低延迟核心: 服务端只有在收到上一帧的 ACK 后才推下一帧, 在途永远 <= 1 帧,\n"
"   所以网络慢/手机解码慢时表现是「掉帧」而不是「越看越延迟」. */\n"
"(function(){\n"
"  var img=$('#camStream');if(!img)return;\n"
"  var ws=null,lastUrl=null,lastFrame=0,retry=0;\n"
"  var reconnTimer=null,mjTimer=null,mjTries=0,mode='init';\n"
"  var ackTimer=null,framePending=false;\n"
"  var fpsCnt=0,fpsLast=Date.now();\n"
"  function sendAck(){\n"
"    if(ackTimer){clearTimeout(ackTimer);ackTimer=null;}\n"
"    if(!framePending)return;\n"
"    framePending=false;\n"
"    if(mode==='ws'&&ws&&ws.readyState===1){try{ws.send('a');}catch(_){}}\n"
"  }\n"
"  function showFrame(blob){\n"
"    var url=URL.createObjectURL(blob);\n"
"    img.src=url;img.style.opacity=1;\n"
"    if(lastUrl)URL.revokeObjectURL(lastUrl);\n"
"    lastUrl=url;lastFrame=Date.now();retry=0;mode='ws';\n"
"    fpsCnt++;\n"
"    /* 关键: 这一帧真正解码上屏后才 ACK; 400ms 兜底防止 load 不触发时断流 */\n"
"    framePending=true;\n"
"    if(ackTimer)clearTimeout(ackTimer);\n"
"    ackTimer=setTimeout(sendAck,400);\n"
"  }\n"
"  function startMjpeg(){\n"
"    if(mode==='mjpeg')return;\n"
"    mode='mjpeg';mjTries=0;framePending=false;\n"
"    if(ackTimer){clearTimeout(ackTimer);ackTimer=null;}\n"
"    img.src='/stream?r='+Date.now();\n"
"  }\n"
"  function connectWs(){\n"
"    if(ws)return;\n"
"    var proto=location.protocol==='https:'?'wss:':'ws:';\n"
"    ws=new WebSocket(proto+'//'+location.host+'/ws_cam');\n"
"    ws.binaryType='blob';\n"
"    ws.onopen=function(){retry=0;};\n"
"    ws.onmessage=function(e){if(e.data instanceof Blob)showFrame(e.data);};\n"
"    ws.onerror=function(){try{ws.close();}catch(_){}};\n"
"    ws.onclose=function(){\n"
"      ws=null;framePending=false;\n"
"      startMjpeg();\n"
"      retry++;\n"
"      var d=Math.min(10000,500*Math.pow(1.5,retry-1));\n"
"      clearTimeout(reconnTimer);\n"
"      reconnTimer=setTimeout(connectWs,d);\n"
"    };\n"
"  }\n"
"  /* MJPEG 兜底期间断流自动重连 */\n"
"  img.addEventListener('error',function(){\n"
"    if(mode!=='mjpeg')return;\n"
"    img.style.opacity=.25;mjTries++;\n"
"    if(mjTries>20)return;\n"
"    clearTimeout(mjTimer);\n"
"    mjTimer=setTimeout(function(){img.src='/stream?r='+Date.now();img.style.opacity=1;},500);\n"
"  });\n"
"  /* 看门狗: WS 已连但 5 秒收不到帧 → 主动降级并稍后重连 */\n"
"  setInterval(function(){\n"
"    if(!ws)return;\n"
"    if(!lastFrame){startMjpeg();return;}\n"
"    if(Date.now()-lastFrame>5000){try{ws.close();}catch(_){}}\n"
"  },2000);\n"
"  img.style.cursor='pointer';img.title='画面卡住? 点击重连';\n"
"  /* 从画面实际像素更新分辨率标签, 并在解码完成时 ACK 让服务端推下一帧 */\n"
"  var lastRes='';\n"
"  img.addEventListener('load',function(){\n"
"    sendAck();\n"
"    var r=img.naturalWidth+'×'+img.naturalHeight;\n"
"    if(r&&r!==lastRes){lastRes=r;var t=$('#resTag');if(t)t.textContent=r;}\n"
"  });\n"
"  img.addEventListener('click',function(){\n"
"    clearTimeout(reconnTimer);retry=0;mjTries=0;framePending=false;\n"
"    if(ws){try{ws.close();}catch(_){}}\n"
"    else connectWs();\n"
"  });\n"
"  /* 实测帧率显示: 判断延迟是网络掉帧还是解码慢, 一眼可见 */\n"
"  setInterval(function(){\n"
"    var n=Date.now()-fpsLast;if(n<1000)return;\n"
"    var el=$('#fpsTag');\n"
"    if(el)el.textContent=(fpsCnt*1000/n).toFixed(1)+' FPS';\n"
"    fpsCnt=0;fpsLast=Date.now();\n"
"  },1000);\n"
"  connectWs();\n"
"})();\n"
"\n"
"/* ===== 时钟 ===== */\n"
"function tick(){\n"
"  const d=new Date(),h=String(d.getHours()).padStart(2,'0'),m=String(d.getMinutes()).padStart(2,'0');\n"
"  const week=['日','一','二','三','四','五','六'];\n"
"  $('#clock').textContent=h+':'+m;\n"
"  $('#date').textContent=(d.getMonth()+1)+'月'+d.getDate()+'日 周'+week[d.getDay()];\n"
"}\n"
"tick();setInterval(tick,1000*15);\n"
"\n"
"/* ===== 同步时间到 ESP32 (发送 UTC 秒级 Unix 时间戳) ===== */\n"
"fetch('/sync_time?timestamp='+Math.floor(Date.now()/1000)).catch(()=>{});\n"
"setInterval(()=>fetch('/sync_time?timestamp='+Math.floor(Date.now()/1000)).catch(()=>{}),60*1000);\n"
"\n"
"/* ===== 按键控制 (D-Pad) — WS 优先, 无 toast 弹窗干扰 ===== */\n"
"(function initDpad(){\n"
"  let last=0,hold=null;\n"
"  function press(cmd){\n"
"    const now=Date.now();if(now-last<50)return;last=now;\n"
"    sendCmd(cmd);\n"
"  }\n"
"  $$('#dpad .btn').forEach(b=>{\n"
"    const cmd=b.dataset.cmd;\n"
"    const start=e=>{e.preventDefault();b.classList.add('active');press(cmd);hold=setInterval(()=>press(cmd),100);};\n"
"    const end  =e=>{e&&e.preventDefault();b.classList.remove('active');if(hold){clearInterval(hold);hold=null;}if(cmd!=='s')sendCmd('s');};\n"
"    b.addEventListener('mousedown',start);b.addEventListener('touchstart',start,{passive:false});\n"
"    b.addEventListener('mouseup',end);b.addEventListener('mouseleave',end);\n"
"    b.addEventListener('touchend',end);b.addEventListener('touchcancel',end);\n"
"  });\n"
"})();\n"
"\n"
"/* ===== 电机转速 3 档 (DRV8833 PWM) ===== */\n"
"var SPEED_META=[\n"
"  {n:'慢',p:'65%',d:'平稳巡航'},\n"
"  {n:'中',p:'82%',d:'快速响应'},\n"
"  {n:'快',p:'100%',d:'全力输出'}\n"
"];\n"
"var speedLevel=2,spTouching=false,spHoldUntil=0;\n"
"function renderSpeed(l){\n"
"  l=Math.max(0,Math.min(2,l|0));speedLevel=l;\n"
"  var m=SPEED_META[l],r=$('#speedRange');\n"
"  if(r){r.value=l;r.style.setProperty('--fill',(l*100/2)+'%');r.setAttribute('aria-valuetext',m.n+' '+m.p);}\n"
"  var n=$('#spName'),p=$('#spPct'),d=$('#spDesc');\n"
"  if(n)n.textContent=m.n;if(p)p.textContent=m.p;if(d)d.textContent=m.d;\n"
"  $$('#spScale .sp-step').forEach(function(b){b.classList.toggle('active',+b.dataset.sp===l);});\n"
"}\n"
"function setSpeed(l){\n"
"  l=Math.max(0,Math.min(2,l|0));\n"
"  if(l===speedLevel)return;\n"
"  renderSpeed(l);spHoldUntil=Date.now()+1500;\n"
"  sendCmd('spd'+l);\n"
"}\n"
"(function initSpeed(){\n"
"  var r=$('#speedRange');if(!r)return;\n"
"  r.addEventListener('input',function(){setSpeed(+r.value);});\n"
"  r.addEventListener('pointerdown',function(){spTouching=true;});\n"
"  r.addEventListener('pointerup',function(){spTouching=false;});\n"
"  r.addEventListener('pointercancel',function(){spTouching=false;});\n"
"  r.addEventListener('blur',function(){spTouching=false;});\n"
"  $$('#spScale .sp-step').forEach(function(b){\n"
"    b.addEventListener('click',function(){setSpeed(+b.dataset.sp);});\n"
"  });\n"
"  renderSpeed(speedLevel);\n"
"})();\n"
"  \n"
"/* ===== 模式切换 ===== */\n"
"function setMode(m){\n"
"  $$('.qa.mode-btn').forEach(b=>b.classList.toggle('active',b.dataset.mode===m));\n"
"  $('#modeTxt').textContent=({off:'休眠',soft:'柔和',normal:'巡航'})[m]||m;\n"
"  if(m==='off'){fetch('/sync_time?timestamp='+Math.floor(Date.now()/1000)).catch(()=>{});}\n"
"  sendCmd('mode_'+m);\n"
"}\n"
"\n"
"/* ===== 屏幕文字发送 ===== */\n"
"function sendText(){\n"
"  const input=$('#textInput');\n"
"  const text=input.value.trim();\n"
"  if(!text){toast('请输入要发送的文字','err');input.focus();return;}\n"
"  if(wsCtrl&&wsCtrl.readyState===1){\n"
"    wsCtrl.send('text='+text);\n"
"    toast('✓ 已发送到屏幕,显示约5秒','ok');\n"
"    input.value='';\n"
"    $('#cbCount').textContent='0/40';\n"
"    input.blur();\n"
"  }else{\n"
"  const url='/display_text?text='+encodeURIComponent(text);\n"
"  fetch(url)\n"
"    .then(r=>{\n"
"      if(r.ok){\n"
"        toast('✓ 已发送到屏幕,显示约5秒','ok');\n"
"        input.value='';\n"
"        $('#cbCount').textContent='0/40';\n"
"        input.blur();\n"
"      }else{\n"
"        r.text().then(msg=>toast('发送失败: '+msg,'err'));\n"
"      }\n"
"    })\n"
"    .catch(()=>toast('网络错误,请检查连接','err'));\n"
"  }\n"
"}\n"
"/* ===== 设备状态轮询 (2s) ===== */\n"
"function fmtUptime(ms){\n"
"  var s=Math.floor(ms/1000),h=Math.floor(s/3600),m=Math.floor(s%3600/60);s=s%60;\n"
"  return (h?h+'h ':'')+(m||h?m+'m ':'')+s+'s';\n"
"}\n"
"function fmtMem(n){return n>=1048576?(n/1048576).toFixed(1)+' MB':Math.round(n/1024)+' KB';}\n"
"var DIR_MAP={STOP:['⏹','待机中'],FWD:['▲','前进中'],BACK:['▼','后退中'],LEFT:['◀','左转中'],RIGHT:['▶','右转中'],LBACK:['↺','左轮反转'],RBACK:['↻','右轮反转'],LFWD:['↶','左轮前进'],RFWD:['↷','右轮前进']};\n"
"var MODE_MAP={off:'休眠',soft:'柔和',normal:'巡航'};\n"
"var RST_MAP={0:'未知',1:'上电启动',2:'外部复位',3:'软件重启',4:'内核崩溃',5:'中断看门狗',6:'任务看门狗',7:'看门狗复位',8:'休眠唤醒',9:'欠压保护',10:'SDIO 复位'};\n"
"async function pollStatus(){\n"
"  try{\n"
"    var j=await (await fetch('/status',{cache:'no-store'})).json();\n"
"    $('#stIp').textContent=j.ip;\n"
"    $('#stSsid').textContent=j.ssid;\n"
"    $('#stRssi').textContent=j.rssi?j.rssi+' dBm':'AP 热点';\n"
"    $('#stUptime').textContent=fmtUptime(j.uptime);\n"
"    $('#stHeap').textContent=fmtMem(j.heap)+' / '+fmtMem(j.psram);\n"
"    $('#stHeapK').textContent='最低水位 '+fmtMem(j.minheap);\n"
"    $('#stTemp').textContent=(j.temp>-50&&j.temp<125)?j.temp.toFixed(1)+' ℃':'--';\n"
"    $('#stRst').textContent=RST_MAP[j.rst]||('复位 '+j.rst);\n"
"    $('#stOnline').textContent=j.wscam+' 人观看';\n"
"    $('#stOnlineK').textContent=j.wifimode==='STA'?('控制 '+j.wsctrl+' 个连接'):('接入 '+j.apstas+' 台 · 控制 '+j.wsctrl);\n"
"    $('#carModeBadge').textContent=MODE_MAP[j.mode]||j.mode;\n"
"    var d=DIR_MAP[j.motor.name]||['•',j.motor.name];\n"
"    $('#carIco').textContent=d[0];$('#carDir').textContent=d[1];\n"
"    var running=j.motor.active&&j.motor.name!=='STOP';\n"
"    $('#carDot').classList.toggle('run',running);\n"
"    $('#carSub').textContent=running?'电机运转中 · 手动控制':'最后动作 '+(j.motor.ago<1000?j.motor.ago+'ms 前':(Math.round(j.motor.ago/100)/10)+'s 前');\n"
"    $$('#moodBar .mood').forEach(function(b){b.classList.toggle('active',+b.dataset.m===j.mood);});\n"
"    if(typeof j.speed==='number'&&!spTouching&&Date.now()>spHoldUntil)renderSpeed(j.speed);\n"
"    var wb=$('#wifiModeBadge');if(wb){wb.textContent=j.wifimode||'AP';wb.className='ws-badge '+(j.wifimode==='STA'?'sta':'ap');}\n"
"    var wss=$('#wifiStatusSsid');if(wss){wss.textContent=j.ssid||'MOCHAN 热点';}\n"
"    var wsi=$('#wifiStatusIp');if(wsi){wsi.textContent=j.ip||'192.168.4.1';}\n"
"    var wsi2=$('#wifiStatusIcon');if(wsi2){wsi2.textContent=(j.wifimode==='STA')?'🌐':'📶';}\n"
"  }catch(e){}\n"
"}\n"
"pollStatus();setInterval(pollStatus,2000);\n"
"/* ===== OLED 表情切换 ===== */\n"
"$$('#moodBar .mood').forEach(function(b){\n"
"  b.addEventListener('click',function(){\n"
"    sendCmd('mood'+b.dataset.m);\n"
"    $$('#moodBar .mood').forEach(function(x){x.classList.remove('active');});\n"
"    b.classList.add('active');\n"
"  });\n"
"});\n"
"/* 默认选中巡航(标题计数区 modeTxt 的初值已在 HTML 中设置) */\n"
"\n"
"/* ===== 快捷操作 ===== */\n"
"function capture(){window.open('/capture','_blank');}\n"
"\n"
"/* ===== 重启 (二次确认) ===== */\n"
"function confirmRestart(){\n"
"  if(!confirm('确认重启设备？约10秒后可重新连接。')) return;\n"
"  toast('正在重启…','ok');\n"
"  fetch('/restart').then(()=>{setTimeout(()=>location.reload(),3000);}).catch(()=>toast('网络错误','err'));\n"
"}\n"
"\n"
"/* ================= AI 目标检测 (YOLOv8n 浏览器端推理) ================= */\n"
"/* 模型与运行时由机器人 LittleFS 通过 /ai/* 提供, 完全离线.\n"
" * 模型输入固定 320x320 (随固件发布的 yolov8n.onnx 即此尺寸). */\n"
"var AIDetector=(function(){\n"
"  var COCO=[\"person\",\"bicycle\",\"car\",\"motorcycle\",\"airplane\",\"bus\",\"train\",\"truck\",\"boat\",\"traffic light\",\n"
"    \"fire hydrant\",\"stop sign\",\"parking meter\",\"bench\",\"bird\",\"cat\",\"dog\",\"horse\",\"sheep\",\"cow\",\n"
"    \"elephant\",\"bear\",\"zebra\",\"giraffe\",\"backpack\",\"umbrella\",\"handbag\",\"tie\",\"suitcase\",\"frisbee\",\n"
"    \"skis\",\"snowboard\",\"sports ball\",\"kite\",\"baseball bat\",\"baseball glove\",\"skateboard\",\"surfboard\",\"tennis racket\",\"bottle\",\n"
"    \"wine glass\",\"cup\",\"fork\",\"knife\",\"spoon\",\"bowl\",\"banana\",\"apple\",\"sandwich\",\"orange\",\n"
"    \"broccoli\",\"carrot\",\"hot dog\",\"pizza\",\"donut\",\"cake\",\"chair\",\"couch\",\"potted plant\",\"bed\",\n"
"    \"dining table\",\"toilet\",\"tv\",\"laptop\",\"mouse\",\"remote\",\"keyboard\",\"cell phone\",\"microwave\",\"oven\",\n"
"    \"toaster\",\"sink\",\"refrigerator\",\"book\",\"clock\",\"vase\",\"scissors\",\"teddy bear\",\"hair drier\",\"toothbrush\"];\n"
"  var session=null,inName=null,outName=null,MW=320,MH=320,busy=false;\n"
"  var SCORE_TH=0.45,NMS_IOU=0.45,MAX_DET=20;\n"
"  function loadScript(url){return new Promise(function(res,rej){\n"
"    var s=document.createElement('script');s.src=url;s.onload=res;\n"
"    s.onerror=function(){rej(new Error('load '+url));};document.head.appendChild(s);});}\n"
"  async function init(opt){\n"
"    if(session)return;\n"
"    if(opt.onProgress)opt.onProgress('加载推理内核…');\n"
"    await loadScript(opt.ortUrl);\n"
"    ort.env.wasm.wasmPaths=opt.wasmBase;ort.env.wasm.numThreads=1;\n"
"    if(opt.onProgress)opt.onProgress('下载 YOLOv8n 模型…');\n"
"    session=await ort.InferenceSession.create(opt.modelUrl,\n"
"      {executionProviders:['wasm'],graphOptimizationLevel:'all'});\n"
"    inName=session.inputNames[0];outName=session.outputNames[0];\n"
"    var md=session.inputMetadata&&session.inputMetadata[inName];\n"
"    var dims=md&&md.dims;\n"
"    if(dims&&dims.length===4){\n"
"      if(typeof dims[2]==='number'&&dims[2]>0)MH=dims[2];\n"
"      if(typeof dims[3]==='number'&&dims[3]>0)MW=dims[3];\n"
"    }\n"
"    if(opt.onProgress)opt.onProgress('AI 就绪 ('+MW+'x'+MH+')');\n"
"  }\n"
"  function preprocess(src){\n"
"    var sw=src.naturalWidth||src.videoWidth||src.width;\n"
"    var sh=src.naturalHeight||src.videoHeight||src.height;\n"
"    var cv=document.createElement('canvas');cv.width=MW;cv.height=MH;\n"
"    var g=cv.getContext('2d',{willReadFrequently:true});\n"
"    g.fillStyle='rgb(114,114,114)';g.fillRect(0,0,MW,MH);\n"
"    var scale=Math.min(MW/sw,MH/sh);\n"
"    var dw=Math.round(sw*scale),dh=Math.round(sh*scale);\n"
"    var padX=Math.floor((MW-dw)/2),padY=Math.floor((MH-dh)/2);\n"
"    g.drawImage(src,0,0,sw,sh,padX,padY,dw,dh);\n"
"    var rgba=g.getImageData(0,0,MW,MH).data;\n"
"    var f32=new Float32Array(3*MW*MH),plane=MW*MH;\n"
"    for(var i=0,p=0;i<plane;i++,p+=4){\n"
"      f32[i]=rgba[p]/255;f32[plane+i]=rgba[p+1]/255;f32[2*plane+i]=rgba[p+2]/255;\n"
"    }\n"
"    return{tensor:new ort.Tensor('float32',f32,[1,3,MH,MW]),scale:scale,padX:padX,padY:padY};\n"
"  }\n"
"  function iou(a,b){\n"
"    var x1=Math.max(a.x,b.x),y1=Math.max(a.y,b.y);\n"
"    var x2=Math.min(a.x+a.w,b.x+b.w),y2=Math.min(a.y+a.h,b.y+b.h);\n"
"    var inter=Math.max(0,x2-x1)*Math.max(0,y2-y1);\n"
"    return inter/(a.w*a.h+b.w*b.h-inter+1e-9);\n"
"  }\n"
"  async function detect(src){\n"
"    if(!session||busy)return null;\n"
"    busy=true;\n"
"    try{\n"
"      var pp=preprocess(src);\n"
"      var feeds={};feeds[inName]=pp.tensor;\n"
"      var res=await session.run(feeds);\n"
"      var out=res[outName],C=out.dims[1],N=out.dims[2],v=out.data;\n"
"      var boxes=[];\n"
"      for(var i=0;i<N;i++){\n"
"        var best=0,bs=0;\n"
"        for(var c=0;c<C-4;c++){var s=v[(4+c)*N+i];if(s>bs){bs=s;best=c;}}\n"
"        if(bs<SCORE_TH)continue;\n"
"        var cx=v[i],cy=v[N+i],w=v[2*N+i],h=v[3*N+i];\n"
"        boxes.push({x:(cx-w/2-pp.padX)/pp.scale,y:(cy-h/2-pp.padY)/pp.scale,\n"
"          w:w/pp.scale,h:h/pp.scale,cls:best,label:COCO[best],score:bs});\n"
"      }\n"
"      boxes.sort(function(a,b){return b.score-a.score;});\n"
"      var keep=[];\n"
"      for(var k=0;k<boxes.length&&keep.length<MAX_DET;k++){\n"
"        var drop=false;\n"
"        for(var m=0;m<keep.length;m++)\n"
"          if(keep[m].cls===boxes[k].cls&&iou(keep[m],boxes[k])>NMS_IOU){drop=true;break;}\n"
"        if(!drop)keep.push(boxes[k]);\n"
"      }\n"
"      return keep;\n"
"    }finally{busy=false;}\n"
"  }\n"
"  return{init:init,detect:detect,ready:function(){return !!session;}};\n"
"})();\n"
"\n"
"var AI=(function(){\n"
"  var on=false,emaMs=0,timer=null,lastPersonSent=0,lastBoxes=[];\n"
"  var followOn=false,folBtn=null,lastTxBucket=999,lastTxMs=0,hadTarget=false;\n"
"  var btn,ov,state;\n"
"  function setState(t){if(state)state.textContent=t||'';}\n"
"  function drawBoxes(boxes){\n"
"    lastBoxes=boxes;\n"
"    var img=$('#camStream');if(!img||!img.naturalWidth)return;\n"
"    var cw=img.clientWidth,ch=img.clientHeight;\n"
"    if(ov.width!==cw||ov.height!==ch){ov.width=cw;ov.height=ch;}\n"
"    var g=ov.getContext('2d');\n"
"    g.clearRect(0,0,cw,ch);\n"
"    var sx=cw/img.naturalWidth,sy=ch/img.naturalHeight;\n"
"    g.font='bold 11px sans-serif';\n"
"    boxes.forEach(function(b){\n"
"      var hue=(b.cls*47)%360;\n"
"      var col='hsl('+hue+',95%,60%)';\n"
"      var x=b.x*sx,y=b.y*sy,w=b.w*sx,h=b.h*sy;\n"
"      g.strokeStyle=col;g.lineWidth=2;g.strokeRect(x,y,w,h);\n"
"      var txt=b.label+' '+Math.round(b.score*100)+'%';\n"
"      var tw=g.measureText(txt).width+8;\n"
"      g.fillStyle=col;\n"
"      g.fillRect(x,Math.max(0,y-15),tw,15);\n"
"      g.fillStyle='#000';\n"
"      g.fillText(txt,x+4,Math.max(11,y-4));\n"
"    });\n"
"    // 跟随模式: 画出中心死区, 框进这两条线之间机器人就不转\n"
"    if(followOn){\n"
"      var cx=cw/2,dz=cw*0.28;\n"
"      g.strokeStyle='rgba(255,255,255,.55)';g.lineWidth=1;\n"
"      g.setLineDash([4,4]);\n"
"      g.beginPath();g.moveTo(cx-dz,0);g.lineTo(cx-dz,ch);g.moveTo(cx+dz,0);g.lineTo(cx+dz,ch);g.stroke();\n"
"      g.setLineDash([]);\n"
"      g.beginPath();g.moveTo(cx,ch/2-8);g.lineTo(cx,ch/2+8);g.moveTo(cx-8,ch/2);g.lineTo(cx+8,ch/2);g.stroke();\n"
"    }\n"
"  }\n"
"  function loop(){\n"
"    if(!on)return;\n"
"    var img=$('#camStream');\n"
"    if(!img||!img.naturalWidth){timer=setTimeout(loop,300);return;}\n"
"    var t0=performance.now();\n"
"    AIDetector.detect(img).then(function(boxes){\n"
"      if(boxes){  // null = 上一帧还没算完, 跳过\n"
"        var dt=performance.now()-t0;\n"
"        emaMs=emaMs?emaMs*0.7+dt*0.3:dt;\n"
"        drawBoxes(boxes);\n"
"        setState(Math.round(emaMs)+'ms · '+boxes.length+' 目标');\n"
"        var person=boxes.some(function(b){return b.cls===0&&b.score>0.6;});\n"
"        if(person&&Date.now()-lastPersonSent>1000){\n"
"          lastPersonSent=Date.now();\n"
"          try{sendCmd('ai:person');}catch(e){}\n"
"        }\n"
"        followUpdate(boxes,img);\n"
"      }\n"
"      // 自适应节流: 慢设备(手机)降低框刷新率, 视频流不受影响\n"
"      var gap=emaMs>250?Math.round(emaMs*0.8):0;\n"
"      timer=setTimeout(loop,gap);\n"
"    }).catch(function(){timer=setTimeout(loop,1000);});\n"
"  }\n"
"  function showModal(){$('#aiModal').classList.add('show');}\n"
"  // ---- 跟随模式: 把画面里最大的人的水平偏移 (-1..1) 发给机器人 ----\n"
"  function followUpdate(boxes,img){\n"
"    if(!followOn)return;\n"
"    var best=null;\n"
"    boxes.forEach(function(b){if(b.cls===0&&b.score>0.5&&(!best||b.w*b.h>best.w*best.h))best=b;});\n"
"    var nowMs=Date.now();\n"
"    if(!best){   // 人丢了: 发一次 0 让机器人停, 之后靠固件 1 秒超时兜底\n"
"      if(hadTarget){hadTarget=false;lastTxBucket=999;try{sendCmd('ai:tx:0.00');}catch(e){}}\n"
"      return;\n"
"    }\n"
"    hadTarget=true;\n"
"    var off=(best.x+best.w/2)/img.naturalWidth*2-1;\n"
"    var bucket=Math.round(off*10)/10;   // 量化到 0.1, 变化才发, 防刷消息\n"
"    if(bucket!==lastTxBucket||nowMs-lastTxMs>200){\n"
"      lastTxBucket=bucket;lastTxMs=nowMs;\n"
"      try{sendCmd('ai:tx:'+bucket.toFixed(2));}catch(e){}\n"
"    }\n"
"  }\n"
"  function setFollow(v,quiet){\n"
"    followOn=v;\n"
"    if(folBtn){folBtn.classList.toggle('on',v);folBtn.textContent=v?'🚶 跟随中':'🚶 跟随';}\n"
"    try{sendCmd(v?'follow_on':'follow_off');}catch(e){}\n"
"    if(!v){hadTarget=false;lastTxBucket=999;}\n"
"    if(!quiet)toast(v?'跟随模式开: 人偏哪边我就转向哪边':'跟随模式已关',v?'ok':'');\n"
"  }\n"
"  async function toggleFollow(){\n"
"    if(followOn){setFollow(false);return;}\n"
"    if(!on){await start();}        // 跟随依赖 AI, 没开就先开\n"
"    if(on)setFollow(true);\n"
"  }\n"
"  async function start(){\n"
"    btn.disabled=true;setState('检查模型…');\n"
"    try{\n"
"      var st=await(await fetch('/ai_status',{cache:'no-store'})).json();\n"
"      if(!st.ready){setState('');btn.disabled=false;showModal();return;}\n"
"      await AIDetector.init({ortUrl:'/ai/ort.wasm.min.js',wasmBase:'/ai/',\n"
"        modelUrl:'/ai/yolov8n.onnx',onProgress:setState});\n"
"      on=true;btn.classList.add('on');btn.disabled=false;btn.textContent='🧠 检测中';\n"
"      toast('AI 检测已开启','ok');\n"
"      loop();\n"
"    }catch(e){\n"
"      setState('启动失败');btn.disabled=false;\n"
"      toast('AI 启动失败: '+e.message,'err');\n"
"    }\n"
"  }\n"
"  function stop(){\n"
"    on=false;btn.classList.remove('on');btn.textContent='🧠 AI 检测';setState('');\n"
"    if(followOn)setFollow(false,true);   // AI 关了跟随必须一起关\n"
"    if(timer){clearTimeout(timer);timer=null;}\n"
"    var g=ov&&ov.getContext('2d');if(g)g.clearRect(0,0,ov.width,ov.height);\n"
"  }\n"
"  function toggle(){\n"
"    if(!on){start();}else{stop();}\n"
"  }\n"
"  function init(){\n"
"    btn=$('#aiBtn');ov=$('#aiOverlay');state=$('#aiState');\n"
"    if(!btn)return;\n"
"    btn.addEventListener('click',toggle);\n"
"    folBtn=$('#followBtn');\n"
"    if(folBtn)folBtn.addEventListener('click',toggleFollow);\n"
"    window.addEventListener('resize',function(){if(on)drawBoxes(lastBoxes);});\n"
"    // 上传 UI\n"
"    var fi=$('#aiFile');\n"
"    if(fi)fi.addEventListener('change',function(){\n"
"      var files=Array.prototype.slice.call(fi.files||[]);\n"
"      if(!files.length)return;\n"
"      var prog=$('#aiUpProg');\n"
"      var names=files.map(function(f){return f.name;}).join(', ');\n"
"      prog.textContent='准备上传: '+names;\n"
"      var chain=Promise.resolve();\n"
"      files.forEach(function(f){\n"
"        chain=chain.then(function(){return uploadOne(f,prog);});\n"
"      });\n"
"      chain.then(function(){\n"
"        prog.textContent='上传完成, 校验中…';\n"
"        return fetch('/ai_status',{cache:'no-store'}).then(function(r){return r.json();});\n"
"      }).then(function(st){\n"
"        if(st&&st.ready){\n"
"          prog.textContent='✅ 模型就绪!';\n"
"          setTimeout(function(){$('#aiModal').classList.remove('show');start();},800);\n"
"        }else if(st){\n"
"          var miss=Object.keys(st.files).filter(function(k){return !st.files[k];}).join('\\n');\n"
"          var hint='';\n"
"          if(!st.fsTotal)hint='\\n❌ 机器人文件系统未挂载！请用 USB 线烧录（OTA 改不了分区表），\\n并选分区方案 16M Flash (3MB APP/9.9MB FATFS)';\n"
"          else if(st.fsTotal<6000000)hint='\\n⚠️ 文件系统只有 '+(st.fsTotal/1048576).toFixed(1)+'MB，分区方案不对：\\n请用 USB 烧录，分区方案选 16M Flash (3MB APP/9.9MB FATFS)';\n"
"          prog.textContent='⚠️ 仍缺文件:\\n'+miss+hint;\n"
"        }\n"
"      }).catch(function(e){prog.textContent='上传失败: '+e.message;});\n"
"    });\n"
"  }\n"
"  function uploadOne(file,prog){\n"
"    return new Promise(function(res,rej){\n"
"      var name=file.name.replace(/\\.gz$/,'');\n"
"      var xhr=new XMLHttpRequest();\n"
"      xhr.open('POST','/ai_upload?name='+encodeURIComponent(name));\n"
"      xhr.upload.onprogress=function(e){\n"
"        if(e.lengthComputable)prog.textContent='上传 '+file.name+' '+Math.round(e.loaded/e.total*100)+'%';\n"
"      };\n"
"      xhr.onload=function(){\n"
"        if(xhr.status===200){res();return;}\n"
"        var msg=file.name+' HTTP '+xhr.status;\n"
"        try{var j=JSON.parse(xhr.responseText);if(j.error)msg=file.name+': '+j.error;}catch(e){}\n"
"        rej(new Error(msg));\n"
"      };\n"
"      xhr.onerror=function(){rej(new Error(file.name+' 网络错误'));};\n"
"      var fd=new FormData();fd.append('file',file,file.name);\n"
"      xhr.send(fd);\n"
"    });\n"
"  }\n"
"  return{init:init};\n"
"})();\n"
"document.addEventListener('DOMContentLoaded',AI.init);\n"
"\n"
"/* ===== 网络状态监控 ===== */\n"
"setInterval(()=>{\n"
"  fetch('/ping',{cache:'no-store'}).then(r=>r.text()).then(t=>{\n"
"    if(t.trim()==='pong'){$('#netState').textContent='联机';}\n"
"    else $('#netState').textContent='异常';\n"
"  }).catch(()=>{$('#netState').textContent='离线';});\n"
"},5000);\n"
"\n"
"/* ===== WiFi 网络设置 ===== */\n"
"function scanWifi(){\n"
"  var btn=event.target,list=$('#wifiList');\n"
"  btn.textContent='扫描中…';btn.disabled=true;\n"
"  fetch('/wifi_scan',{cache:'no-store'}).then(r=>r.json()).then(arr=>{\n"
"    list.innerHTML='';\n"
"    arr.forEach(function(n){\n"
"      var opt=document.createElement('option');\n"
"      opt.value=n.ssid;opt.textContent=n.ssid+' ('+n.rssi+'dBm)';\n"
"      list.appendChild(opt);\n"
"    });\n"
"    list.style.display=arr.length?'block':'none';\n"
"    btn.textContent='🔍扫描';btn.disabled=false;\n"
"    if(!arr.length)toast('未找到WiFi网络','err');\n"
"  }).catch(()=>{toast('扫描失败','err');btn.textContent='🔍扫描';btn.disabled=false;});\n"
"}\n"
"function connectWifi(){\n"
"  var ssid=$('#wifiSsid').value.trim(),pwd=$('#wifiPwd').value;\n"
"  if(!ssid){toast('请输入WiFi名称','err');return;}\n"
"  if(!confirm('设备将重启并连接 '+ssid+'，连接成功后请通过OLED上的新IP访问。继续？'))return;\n"
"  toast('正在保存并重启…','ok');\n"
"  fetch('/wifi_save?ssid='+encodeURIComponent(ssid)+'&pwd='+encodeURIComponent(pwd))\n"
"    .then(()=>{setTimeout(()=>location.reload(),5000);})\n"
"    .catch(()=>toast('请求失败','err'));\n"
"}\n"
"function switchToAP(){\n"
"  if(!confirm('设备将重启切回热点模式(MOCHAN)，约10秒后连接 192.168.4.1。继续？'))return;\n"
"  toast('正在切换…','ok');\n"
"  fetch('/wifi_ap').then(()=>{setTimeout(()=>location.href='http://192.168.4.1',8000);})\n"
"    .catch(()=>toast('请求失败','err'));\n"
"}\n"
"</script>\n"
"</body>";


/* ====== OTA 升级页面 (~302 行 HTML/CSS/JS) ====== */
/* OTA 页面:
 *   - 选择 .bin 固件并计算/填写 MD5
 *   - 上传到 /update
 *   - 显示上传进度, 成功后重启
 * 页面结构同样由 CSS + HTML + JS 字符串拼接而成.
 */
const char PAGE_HTML_OTA[] PROGMEM =
"<!DOCTYPE html>\n"
"<html lang=\"zh-CN\">\n"
"<head>\n"
"<meta charset=\"UTF-8\">\n"
"<meta name=\"viewport\" content=\"width=device-width, initial-scale=1.0, maximum-scale=1.0, user-scalable=no\">\n"
"<meta name=\"theme-color\" content=\"#0B1020\">\n"
"<title>OTA 固件升级 · MOCHAN</title>\n"
"<style>\n"
"*,*::before,*::after{box-sizing:border-box;margin:0;padding:0}\n"
":root{\n"
"  --bg-1:#050816;--bg-2:#0B1030;--bg-3:#101A4A;\n"
"  --glass:rgba(255,255,255,.06);--glass-2:rgba(255,255,255,.10);\n"
"  --border:rgba(255,255,255,.12);\n"
"  --text:#E8ECF5;--text-2:#A8B0C5;--text-3:#76809A;\n"
"  --accent:#5B8CFF;--accent-2:#8A6BFF;--accent-g:linear-gradient(135deg,#5B8CFF,#8A6BFF 60%,#FF6BD6);\n"
"  --danger:#FF4D6A;--success:#3DDC97;--warn:#FFB547;\n"
"  --r-lg:26px;--r-md:18px;--r-sm:12px;\n"
"}\n"
"html,body{height:100%}\n"
"body{\n"
"  font-family:-apple-system,BlinkMacSystemFont,\"Segoe UI\",\"PingFang SC\",\"Microsoft YaHei\",Roboto,sans-serif;\n"
"  color:var(--text);min-height:100vh;\n"
"  background-image:\n"
"    radial-gradient(1200px 600px at 10% -10%,rgba(91,140,255,.35),transparent 60%),\n"
"    radial-gradient(900px 500px at 110% 10%,rgba(138,107,255,.28),transparent 55%),\n"
"    linear-gradient(180deg,var(--bg-1),var(--bg-2) 55%,var(--bg-3));\n"
"  padding:22px 16px 80px;overflow-x:hidden;\n"
"}\n"
".container{max-width:560px;margin:0 auto}\n"
"\n"
".top{display:flex;align-items:center;justify-content:space-between;padding:4px 2px 20px}\n"
".back{display:inline-flex;align-items:center;gap:6px;appearance:none;border:1px solid var(--border);\n"
"  background:var(--glass);color:var(--text);padding:8px 12px;border-radius:999px;cursor:pointer;\n"
"  font-size:12.5px;font-weight:600;backdrop-filter:blur(10px);transition:all .2s;\n"
"}\n"
".back:hover{background:var(--glass-2);transform:translateY(-1px)}\n"
".brand{font-size:12.5px;font-weight:700;letter-spacing:1.5px;color:var(--text-2)}\n"
"\n"
".card{\n"
"  position:relative;margin-top:12px;border-radius:var(--r-lg);\n"
"  background:var(--glass);border:1px solid var(--border);\n"
"  backdrop-filter:blur(18px) saturate(140%);-webkit-backdrop-filter:blur(18px) saturate(140%);\n"
"  box-shadow:0 10px 40px rgba(0,0,0,.45),inset 0 1px 0 rgba(255,255,255,.06);\n"
"  padding:22px 20px 22px;overflow:hidden;\n"
"}\n"
".card::before{content:\"\";position:absolute;inset:-1px;border-radius:inherit;\n"
"  background:linear-gradient(135deg,rgba(255,255,255,.18),transparent 40%,transparent 60%,rgba(138,107,255,.18));\n"
"  -webkit-mask:linear-gradient(#000 0 0) content-box,linear-gradient(#000 0 0);\n"
"  -webkit-mask-composite:xor;mask-composite:exclude;padding:1px;pointer-events:none;\n"
"}\n"
".card>*{position:relative;z-index:1}\n"
"\n"
".hero{text-align:center;padding:8px 4px 4px}\n"
".hero .ico{\n"
"  display:inline-grid;place-items:center;width:72px;height:72px;border-radius:24px;margin:0 auto 14px;\n"
"  background:var(--accent-g);box-shadow:0 16px 44px rgba(91,140,255,.35),inset 0 1px 0 rgba(255,255,255,.25);\n"
"  font-size:32px;transform:translateY(0);animation:float 3.2s ease-in-out infinite;\n"
"}\n"
"@keyframes float{0%,100%{transform:translateY(0)}50%{transform:translateY(-4px)}}\n"
".hero h1{font-size:22px;font-weight:800;letter-spacing:.4px;\n"
"  background:var(--accent-g);-webkit-background-clip:text;background-clip:text;color:transparent;\n"
"}\n"
".hero p{margin-top:6px;font-size:12.5px;color:var(--text-3);line-height:1.6}\n"
"\n"
".warn-box{\n"
"  margin:16px 0 18px;padding:12px 14px;border-radius:var(--r-sm);\n"
"  background:rgba(255,181,71,.08);border:1px solid rgba(255,181,71,.25);\n"
"  display:flex;align-items:flex-start;gap:10px;\n"
"}\n"
".warn-box .icon{font-size:18px;line-height:1.2;flex:0 0 auto}\n"
".warn-box .txt{font-size:12px;color:var(--text-2);line-height:1.65}\n"
".warn-box .txt b{color:var(--warn)}\n"
"\n"
".field{margin-bottom:14px}\n"
".field label{display:block;font-size:12px;color:var(--text-2);margin-bottom:6px;padding-left:2px;font-weight:500}\n"
".field .req{color:var(--danger);margin-left:2px}\n"
"\n"
"/* Custom file upload */\n"
".file{\n"
"  position:relative;border:1.5px dashed rgba(91,140,255,.35);border-radius:var(--r-md);\n"
"  background:rgba(8,12,30,.45);padding:22px 14px;text-align:center;cursor:pointer;transition:all .25s ease;\n"
"}\n"
".file:hover{border-color:rgba(91,140,255,.75);background:rgba(8,12,30,.7);box-shadow:0 10px 30px rgba(91,140,255,.12)}\n"
".file.drag{border-color:var(--accent);box-shadow:0 0 0 4px rgba(91,140,255,.15),0 12px 36px rgba(91,140,255,.2)}\n"
".file input{position:absolute;inset:0;opacity:0;cursor:pointer}\n"
".file .cloud{font-size:34px;margin-bottom:8px}\n"
".file .t1{font-size:13.5px;font-weight:700;color:var(--text)}\n"
".file .t2{font-size:11.5px;color:var(--text-3);margin-top:4px}\n"
".file .sel{margin-top:10px;display:inline-flex;align-items:center;gap:8px;padding:6px 12px;border-radius:999px;\n"
"  background:var(--glass);border:1px solid var(--border);font-size:11.5px;color:var(--text-2);max-width:100%;\n"
"  white-space:nowrap;overflow:hidden;text-overflow:ellipsis;\n"
"}\n"
".file .sel .ok{color:var(--success)}\n"
"\n"
".md5-field{display:flex;gap:8px;align-items:center}\n"
".md5-field input{\n"
"  flex:1;appearance:none;border:1px solid var(--border);background:rgba(8,12,30,.55);\n"
"  color:var(--text);padding:12px 14px;border-radius:var(--r-sm);font-size:13px;outline:none;\n"
"  letter-spacing:.5px;font-family:\"SF Mono\",\"JetBrains Mono\",\"Consolas\",monospace;\n"
"  transition:border-color .2s,box-shadow .2s;\n"
"}\n"
".md5-field input::placeholder{color:var(--text-3)}\n"
".md5-field input:focus{border-color:transparent;box-shadow:0 0 0 2px rgba(91,140,255,.45)}\n"
".md5-hint{font-size:11px;color:var(--text-3);margin-top:6px;line-height:1.6}\n"
".md5-hint code{display:inline-block;padding:1px 6px;border-radius:6px;background:var(--glass);border:1px solid var(--border);color:var(--text-2);font-size:10.5px}\n"
"\n"
"/* Progress */\n"
".prog{margin-top:16px;display:none}\n"
".prog.show{display:block}\n"
".prog-top{display:flex;justify-content:space-between;align-items:center;margin-bottom:8px;font-size:12px}\n"
".prog-top .pct{font-weight:700;color:var(--text)}\n"
".prog-top .lbl{color:var(--text-3)}\n"
".bar{height:10px;width:100%;border-radius:999px;background:rgba(255,255,255,.06);border:1px solid var(--border);overflow:hidden}\n"
".bar > i{display:block;height:100%;width:0%;border-radius:999px;background:var(--accent-g);\n"
"  box-shadow:0 0 18px rgba(91,140,255,.5);transition:width .2s ease;position:relative}\n"
".bar > i::after{content:\"\";position:absolute;inset:0;background:linear-gradient(90deg,transparent,rgba(255,255,255,.35),transparent);\n"
"  animation:shimmer 1.6s linear infinite;\n"
"}\n"
"@keyframes shimmer{from{transform:translateX(-100%)}to{transform:translateX(100%)}}\n"
"\n"
".log{margin-top:14px;padding:10px 12px;border-radius:var(--r-sm);background:rgba(0,0,0,.35);\n"
"  border:1px solid var(--border);font-family:\"SF Mono\",\"JetBrains Mono\",\"Consolas\",monospace;\n"
"  font-size:11.5px;color:var(--text-2);line-height:1.6;min-height:48px;max-height:160px;overflow:auto;\n"
"}\n"
".log .ln{display:block}.log .ok{color:var(--success)}.log .err{color:var(--danger)}.log .dim{color:var(--text-3)}\n"
"\n"
"/* Buttons */\n"
".actions{display:flex;gap:10px;margin-top:18px}\n"
".btn{appearance:none;border:none;cursor:pointer;padding:13px 14px;border-radius:var(--r-sm);\n"
"  font-size:14px;font-weight:700;letter-spacing:.3px;display:inline-flex;align-items:center;justify-content:center;gap:8px;\n"
"  transition:all .2s ease;flex:1;\n"
"}\n"
".btn:disabled{cursor:not-allowed;opacity:.55;filter:saturate(.6)}\n"
".btn-primary{\n"
"  background:var(--accent-g);color:#fff;\n"
"  box-shadow:0 12px 28px rgba(91,140,255,.32),inset 0 1px 0 rgba(255,255,255,.2);\n"
"}\n"
".btn-primary:hover:not(:disabled){transform:translateY(-1px);box-shadow:0 16px 36px rgba(91,140,255,.42)}\n"
".btn-primary:active:not(:disabled){transform:translateY(0)}\n"
".btn-ghost{background:var(--glass);color:var(--text);border:1px solid var(--border);flex:0 0 auto;padding:13px 16px}\n"
".btn-ghost:hover{background:var(--glass-2)}\n"
".btn .spin{width:14px;height:14px;border:2px solid rgba(255,255,255,.3);border-top-color:#fff;border-radius:50%;animation:spin .8s linear infinite}\n"
"@keyframes spin{to{transform:rotate(360deg)}}\n"
"\n"
".steps{margin:18px 0 2px;display:flex;gap:6px}\n"
".steps .s{flex:1;height:4px;border-radius:999px;background:rgba(255,255,255,.06)}\n"
".steps .s.a{background:var(--accent-g)}\n"
"\n"
".footer{margin-top:24px;text-align:center;font-size:11px;color:var(--text-3);letter-spacing:1.2px}\n"
".footer .bar{margin:0 auto 8px;width:38px;height:4px;border-radius:999px;background:linear-gradient(90deg,var(--accent),var(--accent-2));opacity:.7}\n"
"\n"
"/* ===== OTA 桌面/交互体验 ===== */\n"
"@media (hover:hover) and (pointer:fine){\n"
"  html{scroll-behavior:smooth}\n"
"  button:focus-visible,input:focus-visible{\n"
"    outline:none;box-shadow:0 0 0 3px rgba(91,140,255,.45),0 6px 24px rgba(91,140,255,.18);border-radius:inherit\n"
"  }\n"
"  ::selection{background:rgba(91,140,255,.35);color:#fff}\n"
"}\n"
"@media (min-width:768px) and (max-width:1023px){\n"
"  body{padding:28px 20px 80px}\n"
"  .container{max-width:640px}\n"
"  .card{padding:24px 22px}\n"
"}\n"
"@media (min-width:1024px){\n"
"  body{padding:40px 28px 100px}\n"
"  .container{max-width:720px}\n"
"  .top{padding:6px 4px 22px}\n"
"  .top .back{padding:9px 14px;font-size:13px}\n"
"  .top .brand{font-size:13px;letter-spacing:2px}\n"
"  .card{padding:28px 28px 26px;border-radius:28px;margin-top:14px}\n"
"  .hero .ico{width:80px;height:80px;border-radius:28px;font-size:36px}\n"
"  .hero h1{font-size:24px}\n"
"  .hero p{font-size:13px;margin-top:8px}\n"
"  .warn-box{padding:14px 16px;margin:18px 0 20px}\n"
"  .warn-box .icon{font-size:20px}\n"
"  .warn-box .txt{font-size:12.5px;line-height:1.7}\n"
"  .field{margin-bottom:16px}\n"
"  .field label{font-size:12.5px;margin-bottom:8px}\n"
"  .file{padding:28px 18px;border-radius:20px}\n"
"  .file .cloud{font-size:38px}\n"
"  .file .t1{font-size:14px}\n"
"  .file .t2{font-size:12px}\n"
"  .md5-field input{padding:13px 15px;font-size:14px}\n"
"  .md5-hint{font-size:11.5px;margin-top:8px;line-height:1.7}\n"
"  .prog-top{font-size:12.5px;margin-bottom:10px}\n"
"  .bar{height:11px}\n"
"  .log{padding:12px 14px;font-size:12px;line-height:1.7;max-height:200px}\n"
"  .actions{margin-top:20px;gap:12px}\n"
"  .btn{padding:14px 16px;font-size:14px;border-radius:14px}\n"
"  .steps{margin:20px 0 4px;gap:8px}\n"
"  .footer{margin-top:28px;font-size:12px}\n"
"}\n"
"@media (min-width:1440px){\n"
"  .container{max-width:780px}\n"
"  .card{padding:32px 32px 30px;border-radius:30px}\n"
"  body{padding:48px 40px 120px}\n"
"}\n"
"</style>\n"
"</head>\n"
"<body>\n"
"<div class=\"container\">\n"
"\n"
"  <div class=\"top\">\n"
"    <button class=\"back\" onclick=\"location.href='/'\">← 返回控制台</button>\n"
"    <div class=\"brand\">MOCHAN · OTA</div>\n"
"  </div>\n"
"\n"
"  <div class=\"card\">\n"
"    <div class=\"steps\"><div class=\"s a\"></div><div class=\"s\"></div><div class=\"s\"></div></div>\n"
"\n"
"    <div class=\"hero\">\n"
"      <div class=\"ico\">⬆️</div>\n"
"      <h1>OTA 固件升级</h1>\n"
"      <p>空中固件升级 · 选择 <b style=\"color:var(--text)\">.bin</b> 固件并上传，设备将自动写入并重启。</p>\n"
"    </div>\n"
"\n"
"    <div class=\"warn-box\">\n"
"      <span class=\"icon\">⚠️</span>\n"
"      <div class=\"txt\">\n"
"        <div><b>升级过程中请勿断电或刷新页面！</b></div>\n"
"        <div>建议使用已校验 MD5 的官方固件；若升级失败，请使用串口烧录方式恢复。</div>\n"
"      </div>\n"
"    </div>\n"
"\n"
"    <form id=\"otaForm\" method=\"POST\" action=\"/update\" enctype=\"multipart/form-data\" novalidate>\n"
"      <div class=\"field\">\n"
"        <label>固件文件 <span class=\"req\">*</span></label>\n"
"        <label class=\"file\" id=\"drop\">\n"
"          <input type=\"file\" name=\"firmware\" id=\"firmware\" accept=\".bin,application/octet-stream\">\n"
"          <div class=\"cloud\">☁️</div>\n"
"          <div class=\"t1\" id=\"fName\">点击选择或拖拽 .bin 文件到此处</div>\n"
"          <div class=\"t2\" id=\"fHint\">仅支持 .bin 固件文件 · 建议 ≤ 4MB</div>\n"
"          <span class=\"sel\" id=\"fSel\" style=\"display:none\"></span>\n"
"        </label>\n"
"      </div>\n"
"\n"
"      <div class=\"field\">\n"
"        <label>MD5 校验 <span style=\"color:var(--text-3);font-weight:400\">(推荐，用于完整性校验)</span></label>\n"
"        <div class=\"md5-field\">\n"
"          <input type=\"text\" id=\"md5\" name=\"md5\" placeholder=\"例如：d41d8cd98f00b204e9800998ecf8427e\" maxlength=\"32\" autocomplete=\"off\" spellcheck=\"false\">\n"
"        </div>\n"
"        <div class=\"md5-hint\">\n"
"          使用以下命令生成 MD5：\n"
"          <code>certutil -hashfile firmware.bin MD5</code> (Win) ·\n"
"          <code>md5 firmware.bin</code> (Mac) ·\n"
"          <code>md5sum firmware.bin</code> (Linux)\n"
"        </div>\n"
"      </div>\n"
"\n"
"      <div class=\"prog\" id=\"prog\">\n"
"        <div class=\"prog-top\"><span class=\"lbl\" id=\"progLbl\">上传中…</span><span class=\"pct\" id=\"progPct\">0%</span></div>\n"
"        <div class=\"bar\"><i id=\"bar\"></i></div>\n"
"      </div>\n"
"\n"
"      <div class=\"log\" id=\"log\">\n"
"        <span class=\"ln dim\">[ 系统就绪，等待上传固件 ]</span>\n"
"      </div>\n"
"\n"
"      <div class=\"actions\">\n"
"        <button type=\"reset\" class=\"btn btn-ghost\" onclick=\"resetAll()\">重置</button>\n"
"        <button type=\"submit\" class=\"btn btn-primary\" id=\"sbm\" disabled>\n"
"          <span id=\"sbmTxt\">请先选择固件</span>\n"
"        </button>\n"
"      </div>\n"
"    </form>\n"
"  </div>\n"
"\n"
"  <div class=\"footer\"><div class=\"bar\"></div>MOCHAN · OneUI 8.5 · OTA Service</div>\n"
"</div>\n"
"\n"
"<script>\n"
"const $=s=>document.querySelector(s);\n"
"const log=(m,cls)=>{\n"
"  const el=$('#log');\n"
"  const ln=document.createElement('span');ln.className='ln '+(cls||'');ln.textContent='• '+m;\n"
"  el.appendChild(ln);el.scrollTop=el.scrollHeight;\n"
"};\n"
"function fmtSize(n){if(n<1024)return n+' B';if(n<1024*1024)return(n/1024).toFixed(1)+' KB';return(n/1024/1024).toFixed(2)+' MB';}\n"
"\n"
"const steps=$('.steps .s');function setStep(i){steps.forEach((s,idx)=>s.classList.toggle('a',idx<=i));}\n"
"\n"
"/* File picker & drop */\n"
"const f=$('#firmware'),dr=$('#drop'),fName=$('#fName'),fHint=$('#fHint'),fSel=$('#fSel'),sbm=$('#sbm'),sbmTxt=$('#sbmTxt');\n"
"function setFile(file){\n"
"  if(!file){return;}\n"
"  const ok= /\\.bin$/i.test(file.name) || file.type==='application/octet-stream';\n"
"  if(!ok){\n"
"    log('文件类型错误：'+file.name,'err');fName.textContent='文件类型不支持，仅支持 .bin';\n"
"    fSel.style.display='none';sbm.disabled=true;sbmTxt.textContent='请先选择固件';return;\n"
"  }\n"
"  fName.textContent=file.name;\n"
"  fHint.textContent=fmtSize(file.size)+' · 最后修改：'+new Date(file.lastModified).toLocaleString();\n"
"  fSel.style.display='inline-flex';fSel.innerHTML='✅ <span style=\"max-width:220px;overflow:hidden;text-overflow:ellipsis\">'+file.name+'</span>';\n"
"  fSel.classList.add('ok');\n"
"  sbm.disabled=false;sbmTxt.textContent='⬆ 开始升级';\n"
"  log('已选择：'+file.name+' ('+fmtSize(file.size)+')','ok');\n"
"  setStep(1);\n"
"}\n"
"f.addEventListener('change',e=>{if(e.target.files&&e.target.files[0])setFile(e.target.files[0]);});\n"
"['dragenter','dragover'].forEach(ev=>dr.addEventListener(ev,e=>{e.preventDefault();dr.classList.add('drag');}));\n"
"['dragleave','drop'].forEach(ev=>dr.addEventListener(ev,e=>{e.preventDefault();dr.classList.remove('drag');}));\n"
"dr.addEventListener('drop',e=>{if(e.dataTransfer.files&&e.dataTransfer.files[0]){f.files=e.dataTransfer.files;setFile(e.dataTransfer.files[0]);}});\n"
"\n"
"/* Reset */\n"
"function resetAll(){\n"
"  f.value='';fName.textContent='点击选择或拖拽 .bin 文件到此处';\n"
"  fHint.textContent='仅支持 .bin 固件文件 · 建议 ≤ 4MB';\n"
"  fSel.style.display='none';sbm.disabled=true;sbmTxt.textContent='请先选择固件';\n"
"  $('#prog').classList.remove('show');$('#bar').style.width='0%';$('#progPct').textContent='0%';\n"
"  $('#md5').value='';setStep(0);\n"
"}\n"
"\n"
"/* Upload via XHR for progress */\n"
"$('#otaForm').addEventListener('submit',e=>{\n"
"  e.preventDefault();\n"
"  const md5=$('#md5').value.trim().toLowerCase();\n"
"  if(!f.files||!f.files[0]){log('未选择固件文件','err');return;}\n"
"  if(md5&&!/^[a-f0-9]{32}$/.test(md5)){log('MD5 格式错误 (需要 32 位 hex)','err');return;}\n"
"  const fd=new FormData();fd.append('firmware',f.files[0]);\n"
"  const xhr=new XMLHttpRequest();\n"
"  sbm.disabled=true;sbmTxt.innerHTML='<span class=\"spin\"></span>正在上传…';\n"
"  $('#prog').classList.add('show');$('#progLbl').textContent='上传固件中…';\n"
"  const url='/update';\n"
"  xhr.open('POST',url,true);\n"
"  if(md5)xhr.setRequestHeader('X-Firmware-MD5',md5);\n"
"  xhr.upload.onprogress=ev=>{\n"
"    if(!ev.lengthComputable)return;const p=Math.round(ev.loaded/ev.total*100);\n"
"    $('#bar').style.width=p+'%';$('#progPct').textContent=p+'%';\n"
"  };\n"
"  xhr.onload=()=>{\n"
"    if(xhr.status===200&&xhr.responseText.trim()==='OK'){\n"
"      $('#bar').style.width='100%';$('#progPct').textContent='100%';$('#progLbl').textContent='写入完成，设备即将重启…';\n"
"      log('固件写入成功，设备将在 1 秒后自动重启','ok');setStep(2);\n"
"      sbmTxt.innerHTML='✅ 升级完成';\n"
"      let n=6;const iv=setInterval(()=>{\n"
"        log(''+n+' 秒后返回控制台…','dim');--n;if(n<0){clearInterval(iv);location.href='/';}\n"
"      },1000);\n"
"    }else{\n"
"      log('升级失败：HTTP '+xhr.status+' · '+xhr.responseText,'err');setStep(0);\n"
"      sbm.disabled=false;sbmTxt.textContent='重新升级';\n"
"    }\n"
"  };\n"
"  xhr.onerror=()=>{log('网络错误，请检查连接并重试','err');sbm.disabled=false;sbmTxt.textContent='重新升级';};\n"
"  xhr.send(fd);\n"
"  log('开始上传到 '+url+' ...','dim');if(md5)log('携带 MD5 校验头 X-Firmware-MD5: '+md5,'dim');\n"
"});\n"
"</script>\n"
"</body>";
